HuynhMinhThuan1310/UAV-FLIGHT-CONTROLLER/mach-UAV-main/README.md

# UAV Project

Repository for developing a UAV (Unmanned Aerial Vehicle) system.

## Structure
- **hardware/** – UAV hardware design (schematic, PCB)
- **firmware/** – Microcontroller firmware
- **software/** – Supporting software and data processing

## Tools
- KiCad
- STM32CubeIDE
- Python / C++
