HuynhMinhThuan1310/UAV-FLIGHT-CONTROLLER/mach-UAV-main/firmware/README.md

# Firmware

This folder contains firmware for the UAV flight controller.

## Contents
- Microcontroller code
- Sensor drivers
- Motor control (PWM)

## Platform
STM32
