HuynhMinhThuan1310/UAV-FLIGHT-CONTROLLER/mach_flightcontroller (1) (1)/work/prior_layout_adapt/pcb-preview.png

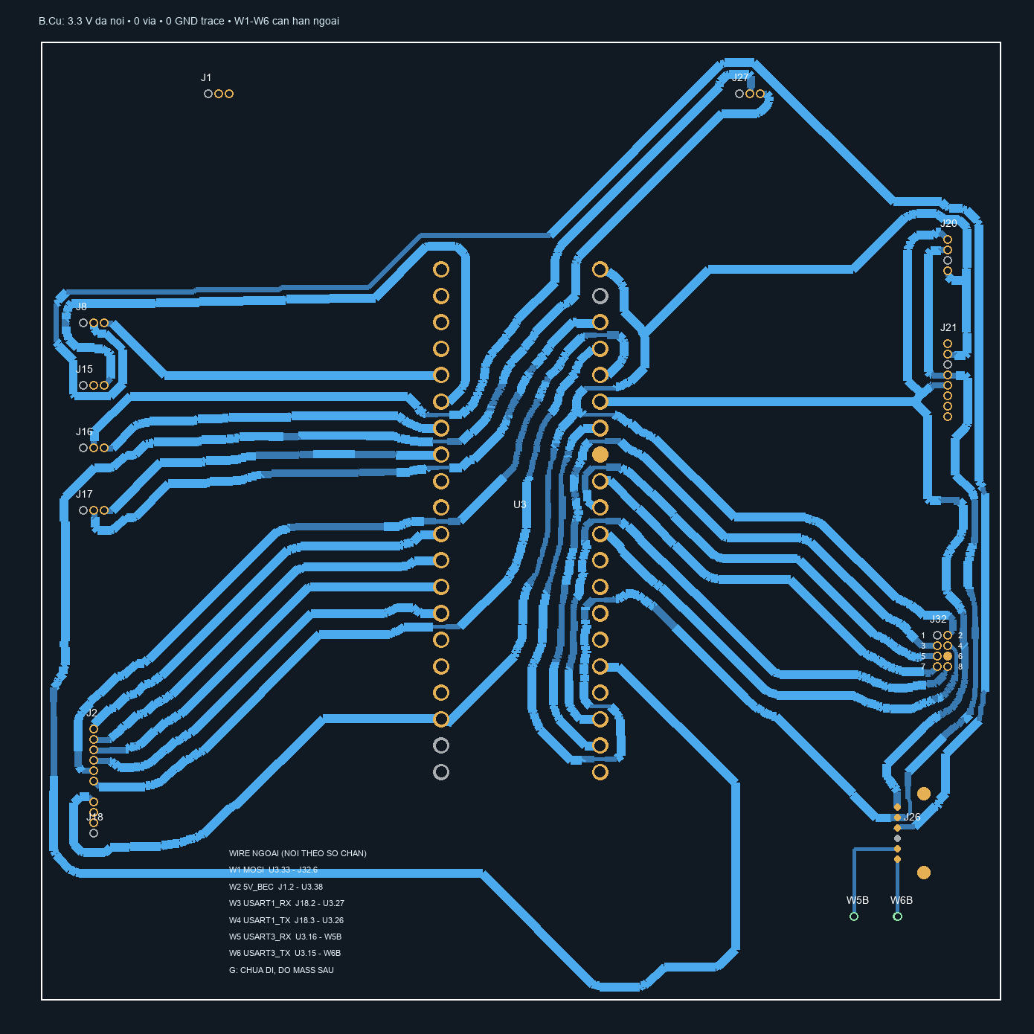
mach_flightcontroller (1) (1)/work/prior_layout_adapt/pcb-preview.png
