HuynhMinhThuan1310/UAV-FLIGHT-CONTROLLER/thiet_ke_mach/work/flightcontroller/pcb-preview.png

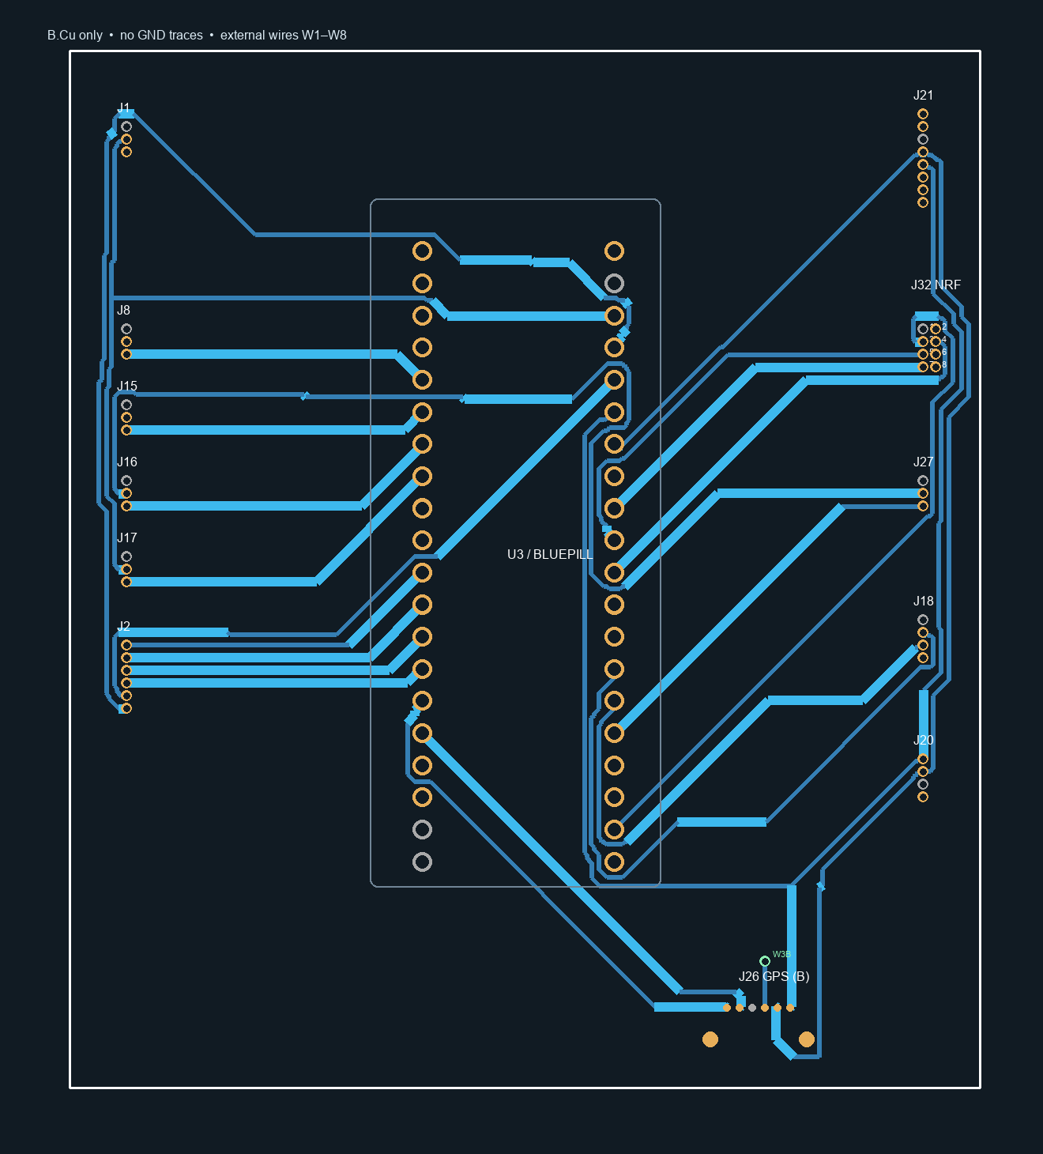
thiet_ke_mach/work/flightcontroller/pcb-preview.png
