HuynhMinhThuan1310/UAV-FLIGHT-CONTROLLER/thiet_ke_mach/work/flightcontroller/preview.png

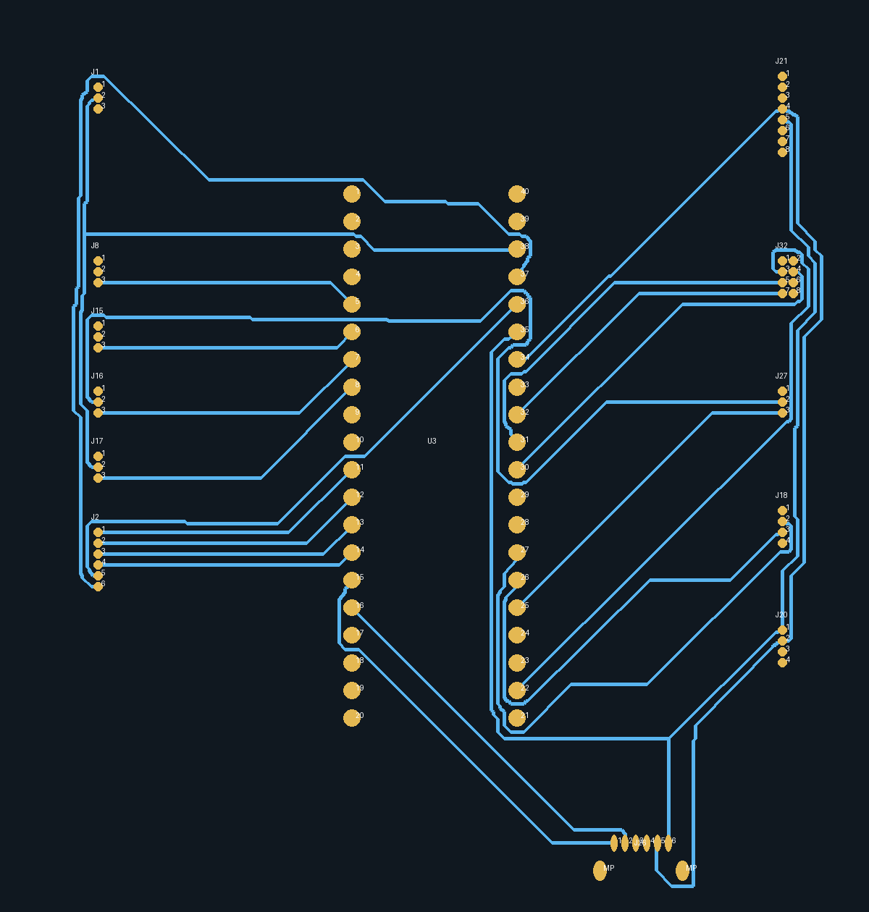
thiet_ke_mach/work/flightcontroller/preview.png
