HuynhMinhThuan1310/UAV-FLIGHT-CONTROLLER/thiet_ke_mach/work/no_ground_refined/preview.png

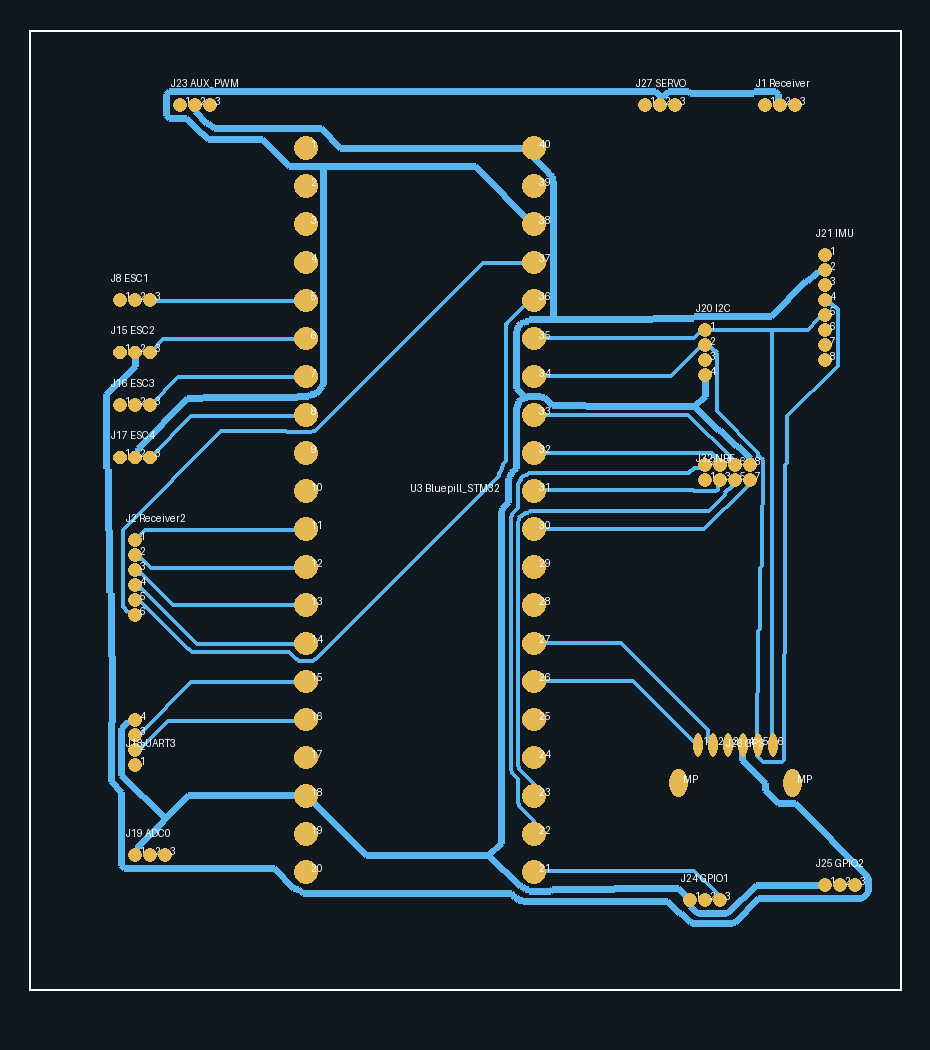
thiet_ke_mach/work/no_ground_refined/preview.png
