HuynhMinhThuan1310/UAV-FLIGHT-CONTROLLER/thiet_ke_mach/work/single_layer/preview.png

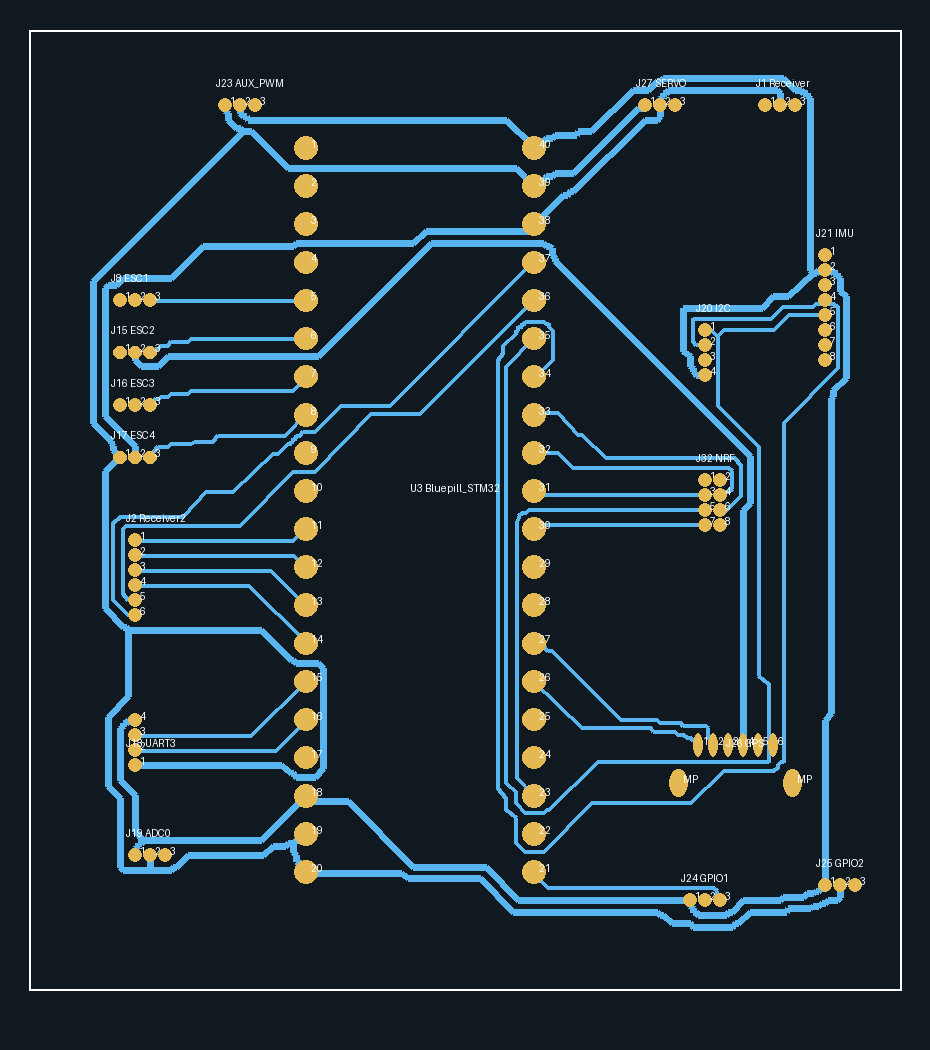
thiet_ke_mach/work/single_layer/preview.png
