HuynhMinhThuan1310/UAV-FLIGHT-CONTROLLER/thiet_ke_mach/work/no_ground_0/candidate.kicad_pcb

## KiCad design thiet_ke_mach/work/no_ground_0/candidate.kicad_pcb (2026-10-14)

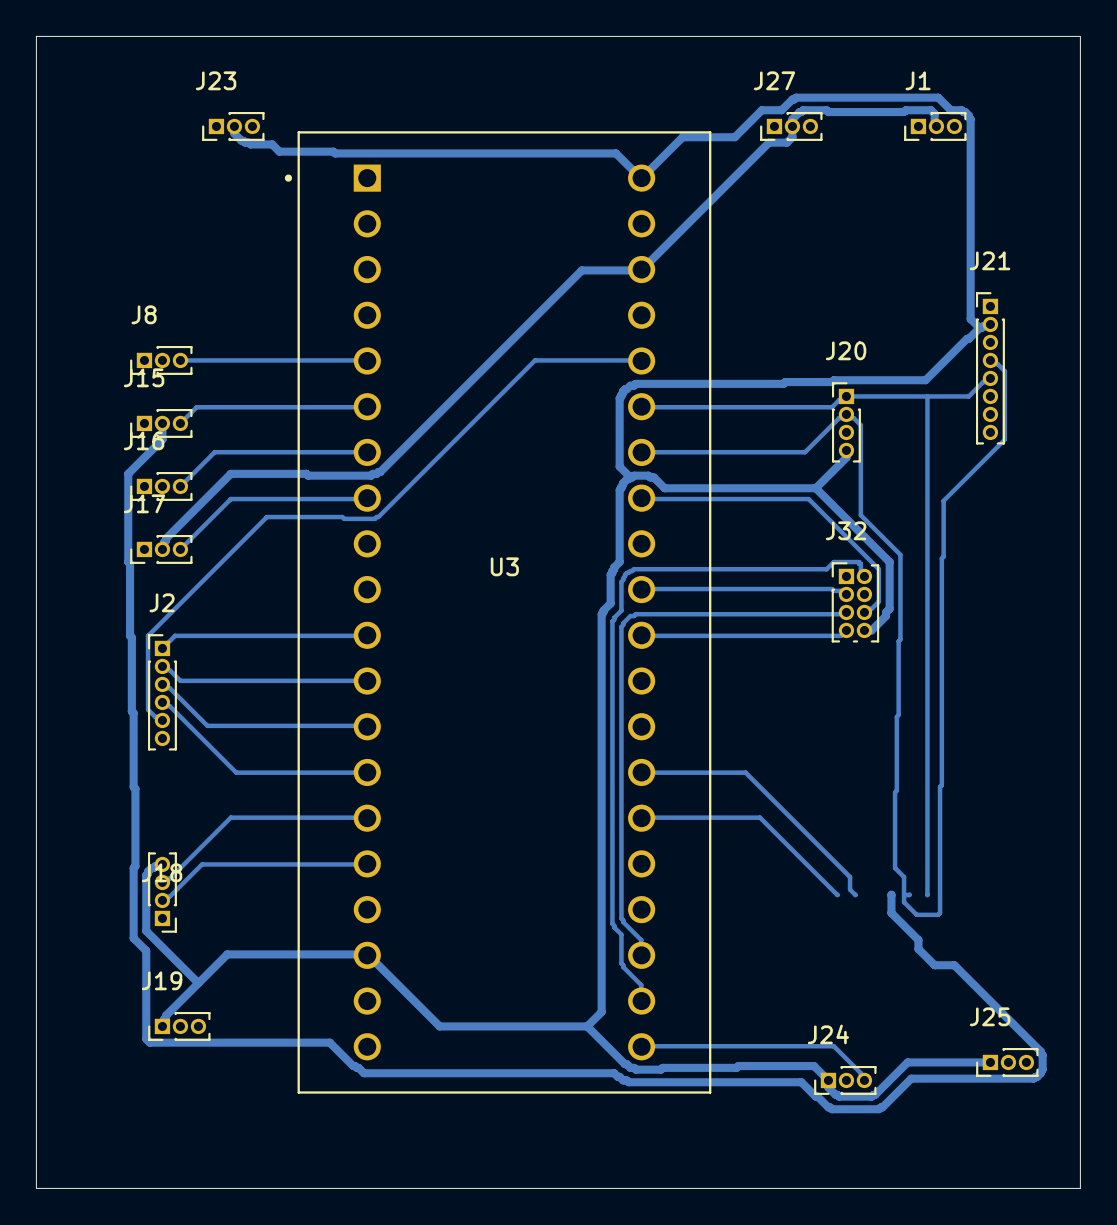
[picture p9: board candidate.kicad_pcb from above]

Board: 2 copper layers, 58.0 x 64.0 mm, 17 parts (1 on the bottom side), 27 nets.

Parts:
J1: Receiver; PinHeader_1x03_P1.00mm_Vertical
J2: Receiver2; PinHeader_1x06_P1.00mm_Vertical
J8: ESC1; PinHeader_1x03_P1.00mm_Vertical
J15: ESC2; PinHeader_1x03_P1.00mm_Vertical
J16: ESC3; PinHeader_1x03_P1.00mm_Vertical
J17: ESC4; PinHeader_1x03_P1.00mm_Vertical
J18: UART3; PinHeader_1x04_P1.00mm_Vertical
J19: ADC0; PinHeader_1x03_P1.00mm_Vertical
J20: I2C; PinHeader_1x04_P1.00mm_Vertical
J21: IMU; PinHeader_1x08_P1.00mm_Vertical
J23: AUX_PWM; PinHeader_1x03_P1.00mm_Vertical
J24: GPIO1; PinHeader_1x03_P1.00mm_Vertical
J25: GPIO2; PinHeader_1x03_P1.00mm_Vertical
J26: GPS; JST_SH_BM06B-SRSS-TB_1x06-1MP_P1.00mm_Vertical
J27: SERVO; PinHeader_1x03_P1.00mm_Vertical
J32: NRF; PinHeader_2x04_P1.00mm_Vertical
U3: Bluepill_STM32; MODULE_ZC323000

Connections:
3.3: J18.4, J19.1, J20.4, J21.2, J23.2, J24.1, J25.1, J32.8, U3.18 (3.3), U3.40 (3.3)
/5V_BEC: J1.2, J17.2, J27.2, U3.38 (5V)
/5V_BEC1: J15.2, J26.4
/B13: J32.2, U3.22 (B13)
/B14: J32.5, U3.23 (B14)
/ESC1: J8.3, U3.5 (A0)
/ESC2: J15.3, U3.6 (A1)
/ESC3: J16.3, U3.7 (A2)
/ESC4: J17.3, U3.8 (A3)
/GPIO1: J24.3, U3.21 (B12)
/RECV-CH6: J2.6, U3.37 (B9)
/RECV_CH1: J2.1, U3.11 (A6)
/RECV_CH2: J2.2, U3.12 (A7)
/RECV_CH3: J2.3, U3.13 (B0)
/RECV_CH4: J2.4, U3.14 (B1)
/RECV_CH5: J2.5, U3.36 (B8)
/SCL: J20.2, J21.4, J26.5, U3.34 (B6)
/SDA: J20.1, J21.5, J26.6, U3.35 (B7)
/SPI1_CS: J32.7, U3.30 (A15)
/SPI1_MISO: J32.4, U3.32 (B4)
/SPI1_MOSI: J32.6, U3.33 (B5)
/SPI1_SCK: J32.3, U3.31 (B3)
/USART1_RX: J26.2, U3.27 (A10)
/USART1_TX: J26.1, U3.26 (A9)
/USART3_RX: J18.2, U3.16 (B11)
/USART3_TX: J18.3, U3.15 (B10)
G: J1.1, J8.1, J15.1, J16.1, J17.1, J18.1, J19.2, J20.3, J21.3, J23.1, J24.2, J25.2, J26.3, J27.1, J32.1, U3.19 (G), U3.20 (G), U3.39 (G)
