HuynhMinhThuan1310/UAV-FLIGHT-CONTROLLER/mach-UAV-main/firmware/uav_complete_fc/Core/Src/main.c

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

/* Includes ------------------------------------------------------------------*/
#include "main.h"

/* USER CODE BEGIN Includes */
#include <math.h>
#include <stdbool.h>
#include <stdio.h>
#include <string.h>
#define USE_BARO                    0U
/* USER CODE END Includes */

/* USER CODE BEGIN PTD */
typedef struct {
  float ax;
  float ay;
  float az;
  float gx;
  float gy;
  float gz;
} ImuSample;

typedef struct {
  float roll_deg;
  float pitch_deg;
  float yaw_deg;
} AttitudeState;

typedef enum {
  FAILSAFE_NONE = 0,
  FAILSAFE_HOLD,
  FAILSAFE_DESCEND,
  FAILSAFE_RECOVER
} FailsafeMode;

typedef struct {
  float kp;
  float ki;
  float kd;
  float integrator;
  float prev_measurement;
  float d_filter;
  float integrator_limit;
  float output_limit;
} PidAxis;

typedef struct {
  bool valid;
  bool rf_loss_detected;
  bool throttle_low;
  bool yaw_arm_request;
  bool yaw_disarm_request;
  float throttle_norm;
  float roll_cmd;
  float pitch_cmd;
  float yaw_cmd;
  uint16_t raw[4];
} RcCommand;

#if USE_BARO
typedef struct {
  int16_t ac1;
  int16_t ac2;
  int16_t ac3;
  uint16_t ac4;
  uint16_t ac5;
  uint16_t ac6;
  int16_t b1;
  int16_t b2;
  int16_t mb;
  int16_t mc;
  int16_t md;
} Bmp180Calib;

typedef enum {
  BARO_STATE_IDLE = 0,
  BARO_STATE_WAIT_TEMP,
  BARO_STATE_WAIT_PRESS
} BaroState;
#endif

/* USER CODE END PTD */

/* USER CODE BEGIN PD */
#define RAD_TO_DEG                  57.29577951f
#define DEG_TO_RAD                  0.01745329252f

#define RC_CHANNELS                 4U

#define LOOP_HZ                     250U
#define LOG_PERIOD_DISARMED_MS      200U
#define LOG_PERIOD_ARMED_MS         500U

#define UART_TX_BUFFER_SIZE         1024U

#define RX_TIMEOUT_MS               120U
#define ARM_HOLD_MS                 3000U
#define DISARM_HOLD_MS              3000U

#define FAILSAFE_AIRBORNE_THROTTLE  0.18f
#define FAILSAFE_HOLD_MS            1300U
#define FAILSAFE_RECOVER_VALID_MS   400U
#define FAILSAFE_RECOVER_BLEND_MS   900U
#define FAILSAFE_DESCEND_RATE_HIGH  0.07f
#define FAILSAFE_DESCEND_RATE_LOW   0.035f
#define FAILSAFE_DESCEND_SPLIT      0.18f
#define FAILSAFE_DESCEND_MIN        0.12f
#define FAILSAFE_DESCEND_FINAL      0.07f
#define FAILSAFE_LAND_ATTITUDE_DEG  14.0f
#define FAILSAFE_LAND_RATE_DPS      35.0f
#define FAILSAFE_LAND_STABLE_MS     1200U
#define RF_PRESET_CENTER_US         1500U
#define RF_PRESET_WINDOW_US         12U
#define RF_PRESET_THROTTLE_MAX_US   950U
#define RF_PRESET_DETECT_MS         120U

#define MOTOR_STOP_US               1000U
#define MOTOR_IDLE_US               1060U
#define MOTOR_MAX_US                2000U
#define MOTOR_HEADROOM_US           260U
#define THROTTLE_LOW_US             1165U

#define RC_VALID_MIN_US             850U
#define RC_VALID_MAX_US             2200U
#define RC_DEADBAND_US              24U

/* Updated from the latest bench logs on the current airframe/radio. */
#define RC_ROLL_MIN_US              1310U
#define RC_ROLL_CENTER_US           1539U
#define RC_ROLL_MAX_US              1808U

#define RC_PITCH_MIN_US             1290U
#define RC_PITCH_CENTER_US          1525U
#define RC_PITCH_MAX_US             1789U

#define RC_YAW_MIN_US               1259U
#define RC_YAW_CENTER_US            1508U
#define RC_YAW_MAX_US               1760U

#define RC_THROTTLE_MIN_US          990U
#define RC_THROTTLE_MAX_US          2120U

#define ARM_YAW_HIGH_US             1700U
#define DISARM_YAW_LOW_US           1320U
#define ARM_STICK_CENTER_WINDOW_US  120U

#define MAX_ANGLE_DEG               14.0f
#define MAX_ANGLE_RATE_DPS          140.0f
#define MAX_YAW_RATE_DPS            140.0f
#define ANGLE_OUTER_KP              5.0f
#define CENTER_BRAKE_STICK_THRESH   0.15f
#define CENTER_BRAKE_KP_BOOST       1.0f
#define HEADING_HOLD_YAW_DEADBAND   0.05f
#define HEADING_HOLD_YAW_EXIT_DB     0.09f
#define HEADING_HOLD_KP             1.85f
#define HEADING_HOLD_RATE_LIMIT_DPS 55.0f
#define HEADING_HOLD_ERROR_LIMIT_DEG 24.0f
#define HEADING_HOLD_RELEASE_MS     120U
#define HEADING_HOLD_MIN_THROTTLE   0.10f
#define HEADING_HOLD_MAX_RP_STICK   0.18f
#define HEADING_HOLD_MAX_TILT_DEG   8.0f
#define HEADING_HOLD_MAX_RP_RATE_DPS 65.0f
#define ACCEL_CORRECTION_GAIN       2.4f
#define ACCEL_TRUST_MAX_ERROR_G     0.35f
#define MAG_YAW_CORRECTION_GAIN     0.30f
#define MAG_CORRECTION_MAX_TILT_DEG 18.0f
#define MAG_CORRECTION_MAX_RP_RATE_DPS 90.0f
#define MAG_CORRECTION_MIN_ACCEL_TRUST 0.35f
#define MAG_CORRECTION_MAX_THR_DELTA 0.040f
#define MAG_FIELD_MIN_GAUSS         0.08f
#define MAG_FIELD_MAX_GAUSS         2.50f
#define MAG_HEADING_JUMP_DEG        35.0f
#define MAG_HEALTH_RECOVER_MS       300U
#define MAG_RAW_LPF_ALPHA           0.12f
#define RC_CENTER_LEARN_ALPHA       0.010f
#define RC_CENTER_LEARN_WINDOW_US   70U
#define RC_CENTER_LEARN_MIN_MS      1200U
#define TILT_THROTTLE_MIN           0.18f
#define TILT_THROTTLE_MAX_BOOST     0.16f
#define YAW_MANEUEVER_STICK_THRESH  0.18f
#define YAW_CONTROL_MIN_THROTTLE    0.10f
#define YAW_MANEUVER_AUTHORITY_MIN  0.60f
#define YAW_INTEGRATOR_DECAY_MANEUVER 0.92f
#define YAW_AUTHORITY_FLOOR         0.68f
#define YAW_DYNAMIC_DAMPING_KP      0.70f
#define YAW_DYNAMIC_DAMPING_THR_KP  0.95f
#define YAW_DYNAMIC_DAMPING_RP_KP   0.55f
#define YAW_THROTTLE_FF            -28.0f
#define YAW_THROTTLE_HIGH_FF       -52.0f
#define YAW_THROTTLE_DELTA_FF      -3.2f
#define YAW_TAKEOFF_BIAS_FF        -9.0f
#define YAW_ROLL_COUPLING_FF        0.0f
#define YAW_PITCH_COUPLING_FF       0.0f
#define YAW_RP_MANEUVER_BIAS_FF    -32.0f
#define YAW_RP_OUTPUT_BIAS_FF      -0.105f
#define YAW_RP_RATE_BIAS_FF        -0.055f
#define YAW_RP_BIAS_THR_GAIN        1.65f
#define YAW_RP_BIAS_LIMIT           115.0f
#define YAW_MIX_SIGN                1.0f
#define YAW_SAT_INTEGRATOR_DECAY    0.94f
#define YAW_BIAS_LEARN_MIN_THROTTLE 0.18f
#define YAW_BIAS_LEARN_MAX_RATE_DPS 85.0f
#define YAW_BIAS_LEARN_GAIN         4.0f
#define YAW_BIAS_DECAY              0.995f
#define YAW_BIAS_SAT_DECAY          0.980f
#define YAW_BIAS_LIMIT              130.0f
#define SENSOR_LEVEL_ROLL_OFFSET_DEG  0.0f
#define SENSOR_LEVEL_PITCH_OFFSET_DEG 0.0f
#define HOVER_ROLL_TRIM_DEG           0.5f
#define HOVER_PITCH_TRIM_DEG          1.6f
#define HOVER_TRIM_START_THROTTLE     0.12f
#define HOVER_TRIM_FULL_THROTTLE      0.35f
#define TAKEOFF_ASSIST_MIN_THROTTLE   0.16f
#define TAKEOFF_ASSIST_MAX_THROTTLE   0.42f
#define TAKEOFF_ASSIST_STICK_THRESH   0.12f
#define TAKEOFF_ASSIST_KP_BOOST       1.0f
#define TAKEOFF_ROLL_TRIM_DEG         0.3f
#define TAKEOFF_PITCH_TRIM_DEG        0.8f
#define STICK_EXPO                  0.70f

#define GYRO_LPF_HZ                 42.0f
#define ACCEL_LPF_HZ                10.0f
#define RC_STICK_ALPHA              0.42f
#define RC_YAW_ALPHA                0.50f
#define RC_THROTTLE_ALPHA           0.06f
#define THROTTLE_EXPO               0.42f
#define THROTTLE_SLEW_UP_PER_S      3.00f
#define THROTTLE_SLEW_DOWN_PER_S    1.50f
#define COMPLEMENTARY_ALPHA         0.985f
#define PID_D_FILTER_CUTOFF_HZ      32.0f

#define GYRO_CALIB_SAMPLES          800U
#define ACCEL_CALIB_SAMPLES         400U
#define IMU_FAIL_LIMIT              10U

#define SENSOR_ROTATION_0           0U
#define SENSOR_ROTATION_90          1U
#define SENSOR_ROTATION_180         2U
#define SENSOR_ROTATION_270         3U
#define SENSOR_ROTATION             SENSOR_ROTATION_0
#define MAG_ROTATION                SENSOR_ROTATION

#define RC_ROLL_SIGN                1.0f
#define RC_PITCH_SIGN              -1.0f
#define RC_YAW_SIGN                 1.0f
#define GYRO_Z_SIGN                 -1.0f
#define MAG_X_SIGN                  1.0f
#define MAG_Y_SIGN                  1.0f
#define MAG_Z_SIGN                  1.0f
#define MAG_OFFSET_X               -0.72f
#define MAG_OFFSET_Y                0.02f
#define MAG_OFFSET_Z                0.00f

#define MPU6050_ADDR                (0x68U << 1)
#define HMC5883L_ADDR               (0x1EU << 1)
#define MPU_REG_SMPLRT_DIV          0x19U
#define MPU_REG_CONFIG              0x1AU
#define MPU_REG_GYRO_CONFIG         0x1BU
#define MPU_REG_ACCEL_CONFIG        0x1CU
#define MPU_REG_INT_PIN_CFG         0x37U
#define MPU_REG_ACCEL_XOUT_H        0x3BU
#define MPU_REG_PWR_MGMT_1          0x6BU
#define MPU_REG_WHO_AM_I            0x75U

#define HMC_REG_CONFIG_A            0x00U
#define HMC_REG_CONFIG_B            0x01U
#define HMC_REG_MODE                0x02U
#define HMC_REG_DATA_X_MSB          0x03U

#define MAG_UPDATE_MS               20U
#define MAG_FAIL_LIMIT              10U

#define MPU_ACCEL_SCALE_4G          8192.0f
#define MPU_GYRO_SCALE_500DPS       65.5f

#define SOFT_I2C_SCL_Pin            GPIO_PIN_6
#define SOFT_I2C_SCL_GPIO_Port      GPIOB
#define SOFT_I2C_SDA_Pin            GPIO_PIN_7
#define SOFT_I2C_SDA_GPIO_Port      GPIOB

#define I2C_TIMEOUT_US              3000U
#define I2C_TIMEOUT_LONG_US         12000U
/* USER CODE END PD */

TIM_HandleTypeDef htim2;
TIM_HandleTypeDef htim3;
UART_HandleTypeDef huart1;

/* USER CODE BEGIN PV */
static volatile uint32_t rc_rise_ticks[RC_CHANNELS] = {0U, 0U, 0U, 0U};
static volatile uint16_t rc_pulse_us[RC_CHANNELS] = {1500U, 1500U, 1000U, 1500U};
static volatile uint8_t rc_edge_state[RC_CHANNELS] = {0U, 0U, 0U, 0U};
static volatile uint32_t rc_last_update_ms[RC_CHANNELS] = {0U, 0U, 0U, 0U};

static uint16_t motor_output_us[4] = {
  MOTOR_STOP_US, MOTOR_STOP_US, MOTOR_STOP_US, MOTOR_STOP_US
};

static AttitudeState attitude = {0.0f, 0.0f, 0.0f};

static PidAxis pid_roll  = {1.18f, 0.42f, 0.046f, 0.0f, 0.0f, 0.0f, 95.0f, 300.0f};
static PidAxis pid_pitch = {1.18f, 0.42f, 0.046f, 0.0f, 0.0f, 0.0f, 95.0f, 300.0f};
static PidAxis pid_yaw   = {2.60f, 0.55f, 0.000f, 0.0f, 0.0f, 0.0f, 120.0f, 340.0f};

static float gyro_bias_x_dps = 0.0f;
static float gyro_bias_y_dps = 0.0f;
static float gyro_bias_z_dps = 0.0f;
static float accel_roll_trim = 0.0f;
static float accel_pitch_trim = 0.0f;

static float gyro_lpf_x = 0.0f;
static float gyro_lpf_y = 0.0f;
static float gyro_lpf_z = 0.0f;
static float accel_lpf_x = 0.0f;
static float accel_lpf_y = 0.0f;
static float accel_lpf_z = 1.0f;

static float rc_roll_filtered = 0.0f;
static float rc_pitch_filtered = 0.0f;
static float rc_yaw_filtered = 0.0f;
static float rc_throttle_filtered = 0.0f;

static bool imu_ready = false;
static bool armed = false;
static bool failsafe_active = true;
static FailsafeMode failsafe_mode = FAILSAFE_NONE;
static uint8_t imu_fail_streak = 0U;
static uint32_t arm_request_ms = 0U;
static uint32_t disarm_request_ms = 0U;
static uint32_t failsafe_state_ms = 0U;
static uint32_t rf_recover_ms = 0U;
static uint32_t land_detect_ms = 0U;
static float failsafe_throttle_norm = 0.0f;
static float last_pilot_throttle_norm = 0.0f;
#if USE_BARO
static Bmp180Calib bmp180_calib = {0};
static BaroState baro_state = BARO_STATE_IDLE;
#endif
static bool mag_ready = false;
static bool mag_usable = false;
static bool mag_correction_allowed = false;
static bool heading_hold_engaged = false;
static bool heading_hold_allowed = false;
static bool mag_calibrated = true;
static uint8_t mag_fail_streak = 0U;
#if USE_BARO
static uint8_t baro_fail_streak = 0U;
#endif
static uint32_t last_mag_update_ms = 0U;
#if USE_BARO
static uint32_t last_baro_update_ms = 0U;
#endif
static uint32_t last_heading_hold_ms = 0U;
static uint32_t rf_preset_detect_ms = 0U;
static uint32_t mag_good_since_ms = 0U;
static uint32_t rc_center_learn_ms = 0U;
#if USE_BARO
static uint32_t baro_deadline_ms = 0U;
#endif
static float throttle_command_norm = 0.0f;
static float heading_deg = 0.0f;
static float heading_hold_ref_deg = 0.0f;
static float mag_heading_deg = 0.0f;
static float mag_field_strength = 0.0f;
static float mag_field_filtered = 0.0f;
static float mag_heading_jump = 0.0f;
static float mag_offset_x = MAG_OFFSET_X;
static float mag_offset_y = MAG_OFFSET_Y;
static float mag_offset_z = MAG_OFFSET_Z;
static float mag_raw_x = 0.0f;
static float mag_raw_y = 0.0f;
static float mag_raw_z = 0.0f;
static float mag_lpf_x = 0.0f;
static float mag_lpf_y = 0.0f;
static float mag_lpf_z = 0.0f;
static bool mag_heading_valid = false;
static float rc_roll_center_runtime = (float)RC_ROLL_CENTER_US;
static float rc_pitch_center_runtime = (float)RC_PITCH_CENTER_US;
static float rc_yaw_center_runtime = (float)RC_YAW_CENTER_US;
static float accel_norm = 1.0f;
static float accel_trust = 0.0f;
static float throttle_tilt_boost = 0.0f;
static float takeoff_assist_scale = 0.0f;
static float last_roll_pid_output = 0.0f;
static float last_pitch_pid_output = 0.0f;
static float last_yaw_pid_output = 0.0f;
static float last_desired_yaw_rate = 0.0f;
static float last_gyro_x_dps = 0.0f;
static float last_gyro_y_dps = 0.0f;
static float last_heading_error_deg = 0.0f;
static float last_gyro_z_dps = 0.0f;
static float last_control_throttle_norm = 0.0f;
static float throttle_delta_norm = 0.0f;
static float throttle_rate_norm_s = 0.0f;
static float yaw_dynamic_damping_output = 0.0f;
static float yaw_throttle_feedforward_output = 0.0f;
static float yaw_feedforward_output = 0.0f;
static float yaw_maneuver_bias_output = 0.0f;
static float yaw_bias_output = 0.0f;
static float heading_hold_limited_error_deg = 0.0f;
static float mixer_yaw_scale = 1.0f;
static float mixer_rp_scale = 1.0f;
static float yaw_maneuver_scale = 1.0f;
static bool roll_pitch_dynamic = false;
static bool mixer_saturated = false;
#if USE_BARO
static float baro_temperature_c = 0.0f;
static float baro_pressure_hpa = 0.0f;
static float baro_pressure_filtered_hpa = 0.0f;
static float baro_altitude_m = 0.0f;
static float baro_altitude_filtered_m = 0.0f;
static float baro_altitude_ref_m = 0.0f;
static float baro_relative_altitude_m = 0.0f;
static int32_t baro_ut = 0;
static int32_t baro_b5 = 0;
static bool baro_ref_valid = false;
static float baro_ref_accum_m = 0.0f;
static uint16_t baro_ref_samples = 0U;
#endif

static char uart_buf[768];
static volatile char uart_tx_ring[UART_TX_BUFFER_SIZE];
static volatile uint16_t uart_tx_head = 0U;
static volatile uint16_t uart_tx_tail = 0U;
/* USER CODE END PV */

void SystemClock_Config(void);
static void MX_GPIO_Init(void);
static void MX_TIM2_Init(void);
static void MX_TIM3_Init(void);
static void MX_USART1_UART_Init(void);
/* USER CODE BEGIN PFP */
static void dwt_init(void);
static uint32_t dwt_cycles32(void);
static void uart_log(const char *text);
static void uart_start_tx(void);
static void set_status_led(bool on);
static void update_status_led(void);

static float clampf(float value, float min_value, float max_value);
static float apply_expo(float value, float expo);
static float lpf_alpha(float cutoff_hz, float dt);
static float lpf_apply(float previous, float input, float alpha);
static uint16_t pulse_distance_us(uint16_t a, uint16_t b);
static float normalize_centered(uint16_t pulse_us,
                                uint16_t min_us,
                                float center_us,
                                uint16_t max_us,
                                float sign);
static float normalize_throttle(uint16_t pulse_us);
static float apply_throttle_curve(float value);
static void rotate_xy(float *x, float *y);
static void rotate_mag_axes(float *x, float *y, float *z);
static void update_rc_center_learning(RcCommand *command, uint32_t now_ms);
static float control_roll_accel_deg(const ImuSample *sample);
static float control_pitch_accel_deg(const ImuSample *sample);
static float control_roll_rate_dps(const ImuSample *sample);
static float control_pitch_rate_dps(const ImuSample *sample);
static float control_yaw_rate_dps(const ImuSample *sample);
static float hover_trim_scale(float throttle_norm);

static void pid_reset(PidAxis *pid);
static void reset_all_pids(void);
static float pid_update(PidAxis *pid, float setpoint, float measurement, float dt, bool enable_integrator);

static void hw_i2c1_init(void);
static bool hw_i2c_wait_flag(volatile uint32_t *reg, uint32_t flag, bool set, uint32_t timeout_us);
static bool hw_i2c_write_register(uint8_t device_addr, uint8_t reg, uint8_t value);
static bool hw_i2c_read_registers(uint8_t device_addr, uint8_t reg, uint8_t *buffer, uint16_t length);
static bool imu_write_reg(uint8_t reg, uint8_t value);
static bool imu_read_regs(uint8_t reg, uint8_t *buffer, uint16_t length);
static bool mpu6050_init(void);
static bool mpu6050_enable_bypass(void);
static bool mpu6050_read_raw(ImuSample *sample);
static bool mpu6050_read_filtered(ImuSample *sample, float dt);
static bool mpu6050_calibrate(void);
static void update_attitude(const ImuSample *sample, float dt);

static bool receiver_read_command(RcCommand *command, uint32_t now_ms);
static bool hmc5883l_init(void);
static bool hmc5883l_read(float *mx, float *my, float *mz);
static float wrap_heading_deg(float heading_deg_value);
static float heading_error_deg(float target_deg, float current_deg);
static float compute_heading_deg(float mx, float my, float mz, float pitch_deg, float roll_deg);
#if USE_BARO
static bool bmp180_read_calib(void);
static float compute_altitude_m(float pressure_hpa);
static bool bmp180_start_temp(void);
static bool bmp180_read_ut(int32_t *ut);
static bool bmp180_start_pressure(void);
static bool bmp180_read_up(int32_t *up);
static void bmp180_compute(int32_t ut, int32_t up, float *temperature_c, float *pressure_hpa);
#endif
static void update_aux_sensors(uint32_t now_ms);

static bool detect_rf_loss_pattern(const RcCommand *command);
static bool command_is_centered(const RcCommand *command);
static void update_failsafe_state(const RcCommand *command,
                                  bool sensors_ok,
                                  const ImuSample *sample,
                                  bool sample_valid,
                                  uint32_t now_ms,
                                  float dt);
static void update_arming_state(const RcCommand *command, bool sensors_ok, uint32_t now_ms);
static float apply_throttle_slew(float target_norm, float dt, bool reset_state);
static void build_control_command(const RcCommand *pilot_command,
                                  RcCommand *control_command,
                                  uint32_t now_ms,
                                  float dt);
static void enter_rf_failsafe(uint32_t now_ms);

static void motor_set_us(uint8_t motor_index, uint16_t pulse_us);
static void motors_write_all(uint16_t m1, uint16_t m2, uint16_t m3, uint16_t m4);
static void stop_all_motors(void);
static void mix_motor_outputs(float throttle_base,
                              float roll_output,
                              float pitch_output,
                              float yaw_output);
static void run_flight_control(const RcCommand *command, const ImuSample *sample, float dt);
static void log_status(const RcCommand *command);
/* USER CODE END PFP */

/* USER CODE BEGIN 0 */
static void dwt_init(void)
{
  CoreDebug->DEMCR |= CoreDebug_DEMCR_TRCENA_Msk;
  DWT->CYCCNT = 0U;
  DWT->CTRL |= DWT_CTRL_CYCCNTENA_Msk;
}

static uint32_t dwt_cycles32(void)
{
  return DWT->CYCCNT;
}

static void uart_log(const char *text)
{
  __disable_irq();

  while (*text != '\0') {
    const uint16_t next_head = (uint16_t)((uart_tx_head + 1U) % UART_TX_BUFFER_SIZE);

    if (next_head == uart_tx_tail) {
      break;
    }

    uart_tx_ring[uart_tx_head] = *text;
    uart_tx_head = next_head;
    text++;
  }

  __enable_irq();
  uart_start_tx();
}

static void uart_start_tx(void)
{
  __HAL_UART_ENABLE_IT(&huart1, UART_IT_TXE);
}

void uart1_irq_handler(void)
{
  if ((__HAL_UART_GET_IT_SOURCE(&huart1, UART_IT_TXE) != RESET) &&
      (__HAL_UART_GET_FLAG(&huart1, UART_FLAG_TXE) != RESET)) {
    if (uart_tx_tail != uart_tx_head) {
      huart1.Instance->DR = (uint16_t)(uint8_t)uart_tx_ring[uart_tx_tail];
      uart_tx_tail = (uint16_t)((uart_tx_tail + 1U) % UART_TX_BUFFER_SIZE);
    } else {
      __HAL_UART_DISABLE_IT(&huart1, UART_IT_TXE);
    }
  }
}

static void set_status_led(bool on)
{
  HAL_GPIO_WritePin(STATUS_LED_GPIO_Port,
                    STATUS_LED_Pin,
                    on ? GPIO_PIN_RESET : GPIO_PIN_SET);
}

static void update_status_led(void)
{
  static uint32_t last_toggle_ms = 0U;
  static bool led_on = false;
  const uint32_t now_ms = HAL_GetTick();
  uint32_t period_ms = 500U;

  if (!imu_ready) {
    period_ms = 120U;
  } else if (failsafe_active) {
    period_ms = 100U;
  } else if (!armed) {
    period_ms = 450U;
  } else {
    set_status_led(true);
    return;
  }

  if ((uint32_t)(now_ms - last_toggle_ms) >= period_ms) {
    last_toggle_ms = now_ms;
    led_on = !led_on;
    set_status_led(led_on);
  }
}

static void hw_i2c1_init(void)
{
  GPIO_InitTypeDef GPIO_InitStruct = {0};

  __HAL_RCC_GPIOB_CLK_ENABLE();
  __HAL_RCC_I2C1_CLK_ENABLE();

  GPIO_InitStruct.Pin = SOFT_I2C_SCL_Pin | SOFT_I2C_SDA_Pin;
  GPIO_InitStruct.Mode = GPIO_MODE_OUTPUT_OD;
  GPIO_InitStruct.Speed = GPIO_SPEED_FREQ_HIGH;
  HAL_GPIO_Init(GPIOB, &GPIO_InitStruct);

  HAL_GPIO_WritePin(GPIOB, SOFT_I2C_SCL_Pin | SOFT_I2C_SDA_Pin, GPIO_PIN_SET);
  for (uint8_t i = 0U; i < 9U; i++) {
    HAL_GPIO_WritePin(GPIOB, SOFT_I2C_SCL_Pin, GPIO_PIN_RESET);
    for (volatile uint32_t delay = 0U; delay < 80U; delay++) { __NOP(); }
    HAL_GPIO_WritePin(GPIOB, SOFT_I2C_SCL_Pin, GPIO_PIN_SET);
    for (volatile uint32_t delay = 0U; delay < 80U; delay++) { __NOP(); }
  }
  HAL_GPIO_WritePin(GPIOB, SOFT_I2C_SDA_Pin, GPIO_PIN_RESET);
  for (volatile uint32_t delay = 0U; delay < 80U; delay++) { __NOP(); }
  HAL_GPIO_WritePin(GPIOB, SOFT_I2C_SCL_Pin, GPIO_PIN_SET);
  for (volatile uint32_t delay = 0U; delay < 80U; delay++) { __NOP(); }
  HAL_GPIO_WritePin(GPIOB, SOFT_I2C_SDA_Pin, GPIO_PIN_SET);

  GPIO_InitStruct.Pin = SOFT_I2C_SCL_Pin | SOFT_I2C_SDA_Pin;
  GPIO_InitStruct.Mode = GPIO_MODE_AF_OD;
  GPIO_InitStruct.Speed = GPIO_SPEED_FREQ_HIGH;
  HAL_GPIO_Init(GPIOB, &GPIO_InitStruct);

  __HAL_RCC_I2C1_FORCE_RESET();
  __HAL_RCC_I2C1_RELEASE_RESET();

  I2C1->CR1 = 0U;
  I2C1->CR2 = 36U;
  I2C1->CCR = 180U;
  I2C1->TRISE = 37U;
  I2C1->CR1 = I2C_CR1_PE;
}

static bool hw_i2c_wait_flag(volatile uint32_t *reg, uint32_t flag, bool set, uint32_t timeout_us)
{
  const uint32_t start = dwt_cycles32();
  const uint32_t timeout_cycles = timeout_us * (SystemCoreClock / 1000000U);

  while (((*reg & flag) != 0U) != set) {
    if ((uint32_t)(dwt_cycles32() - start) > timeout_cycles) {
      return false;
    }
  }
  return true;
}

static bool hw_i2c_write_register(uint8_t device_addr, uint8_t reg, uint8_t value)
{
  if (!hw_i2c_wait_flag(&I2C1->SR2, I2C_SR2_BUSY, false, I2C_TIMEOUT_LONG_US)) {
    hw_i2c1_init();
    return false;
  }

  I2C1->CR1 |= I2C_CR1_START;
  if (!hw_i2c_wait_flag(&I2C1->SR1, I2C_SR1_SB, true, I2C_TIMEOUT_US)) {
    hw_i2c1_init();
    return false;
  }
  I2C1->DR = device_addr & 0xFEU;
  if (!hw_i2c_wait_flag(&I2C1->SR1, I2C_SR1_ADDR, true, I2C_TIMEOUT_US)) {
    I2C1->CR1 |= I2C_CR1_STOP;
    hw_i2c1_init();
    return false;
  }
  (void)I2C1->SR1;
  (void)I2C1->SR2;

  if (!hw_i2c_wait_flag(&I2C1->SR1, I2C_SR1_TXE, true, I2C_TIMEOUT_US)) {
    I2C1->CR1 |= I2C_CR1_STOP;
    return false;
  }
  I2C1->DR = reg;
  if (!hw_i2c_wait_flag(&I2C1->SR1, I2C_SR1_BTF, true, I2C_TIMEOUT_US)) {
    I2C1->CR1 |= I2C_CR1_STOP;
    return false;
  }
  I2C1->DR = value;
  if (!hw_i2c_wait_flag(&I2C1->SR1, I2C_SR1_BTF, true, I2C_TIMEOUT_US)) {
    I2C1->CR1 |= I2C_CR1_STOP;
    return false;
  }

  I2C1->CR1 |= I2C_CR1_STOP;
  return true;
}

static bool hw_i2c_read_registers(uint8_t device_addr, uint8_t reg, uint8_t *buffer, uint16_t length)
{
  if (length == 0U) {
    return true;
  }

  if (!hw_i2c_wait_flag(&I2C1->SR2, I2C_SR2_BUSY, false, I2C_TIMEOUT_LONG_US)) {
    hw_i2c1_init();
    return false;
  }

  I2C1->CR1 |= I2C_CR1_ACK;
  I2C1->CR1 |= I2C_CR1_START;
  if (!hw_i2c_wait_flag(&I2C1->SR1, I2C_SR1_SB, true, I2C_TIMEOUT_US)) {
    hw_i2c1_init();
    return false;
  }
  I2C1->DR = device_addr & 0xFEU;
  if (!hw_i2c_wait_flag(&I2C1->SR1, I2C_SR1_ADDR, true, I2C_TIMEOUT_US)) {
    I2C1->CR1 |= I2C_CR1_STOP;
    hw_i2c1_init();
    return false;
  }
  (void)I2C1->SR1;
  (void)I2C1->SR2;

  if (!hw_i2c_wait_flag(&I2C1->SR1, I2C_SR1_TXE, true, I2C_TIMEOUT_US)) {
    I2C1->CR1 |= I2C_CR1_STOP;
    return false;
  }
  I2C1->DR = reg;
  if (!hw_i2c_wait_flag(&I2C1->SR1, I2C_SR1_BTF, true, I2C_TIMEOUT_US)) {
    I2C1->CR1 |= I2C_CR1_STOP;
    return false;
  }

  I2C1->CR1 |= I2C_CR1_START;
  if (!hw_i2c_wait_flag(&I2C1->SR1, I2C_SR1_SB, true, I2C_TIMEOUT_US)) {
    hw_i2c1_init();
    return false;
  }
  I2C1->DR = device_addr | 0x01U;

  if (length == 1U) {
    if (!hw_i2c_wait_flag(&I2C1->SR1, I2C_SR1_ADDR, true, I2C_TIMEOUT_US)) {
      I2C1->CR1 |= I2C_CR1_STOP;
      return false;
    }
    I2C1->CR1 &= ~I2C_CR1_ACK;
    __disable_irq();
    (void)I2C1->SR1;
    (void)I2C1->SR2;
    I2C1->CR1 |= I2C_CR1_STOP;
    __enable_irq();
    if (!hw_i2c_wait_flag(&I2C1->SR1, I2C_SR1_RXNE, true, I2C_TIMEOUT_US)) {
      return false;
    }
    buffer[0] = (uint8_t)I2C1->DR;
    I2C1->CR1 |= I2C_CR1_ACK;
    return true;
  }

  if (length == 2U) {
    I2C1->CR1 |= I2C_CR1_POS;
    if (!hw_i2c_wait_flag(&I2C1->SR1, I2C_SR1_ADDR, true, I2C_TIMEOUT_US)) {
      I2C1->CR1 |= I2C_CR1_STOP;
      I2C1->CR1 &= ~I2C_CR1_POS;
      return false;
    }
    I2C1->CR1 &= ~I2C_CR1_ACK;
    __disable_irq();
    (void)I2C1->SR1;
    (void)I2C1->SR2;
    __enable_irq();
    if (!hw_i2c_wait_flag(&I2C1->SR1, I2C_SR1_BTF, true, I2C_TIMEOUT_US)) {
      I2C1->CR1 &= ~I2C_CR1_POS;
      return false;
    }
    __disable_irq();
    I2C1->CR1 |= I2C_CR1_STOP;
    buffer[0] = (uint8_t)I2C1->DR;
    __enable_irq();
    buffer[1] = (uint8_t)I2C1->DR;
    I2C1->CR1 &= ~I2C_CR1_POS;
    I2C1->CR1 |= I2C_CR1_ACK;
    return true;
  }

  if (!hw_i2c_wait_flag(&I2C1->SR1, I2C_SR1_ADDR, true, I2C_TIMEOUT_US)) {
    I2C1->CR1 |= I2C_CR1_STOP;
    return false;
  }
  (void)I2C1->SR1;
  (void)I2C1->SR2;

  while (length > 3U) {
    if (!hw_i2c_wait_flag(&I2C1->SR1, I2C_SR1_RXNE, true, I2C_TIMEOUT_US)) {
      I2C1->CR1 |= I2C_CR1_STOP;
      return false;
    }
    *buffer++ = (uint8_t)I2C1->DR;
    length--;
  }

  if (!hw_i2c_wait_flag(&I2C1->SR1, I2C_SR1_BTF, true, I2C_TIMEOUT_US)) {
    I2C1->CR1 |= I2C_CR1_STOP;
    return false;
  }
  I2C1->CR1 &= ~I2C_CR1_ACK;
  __disable_irq();
  *buffer++ = (uint8_t)I2C1->DR;
  I2C1->CR1 |= I2C_CR1_STOP;
  __enable_irq();
  *buffer++ = (uint8_t)I2C1->DR;
  if (!hw_i2c_wait_flag(&I2C1->SR1, I2C_SR1_RXNE, true, I2C_TIMEOUT_US)) {
    return false;
  }
  *buffer = (uint8_t)I2C1->DR;
  I2C1->CR1 |= I2C_CR1_ACK;
  return true;
}

static bool hmc5883l_init(void)
{
  return hw_i2c_write_register(HMC5883L_ADDR, HMC_REG_CONFIG_A, 0x70U) &&
         hw_i2c_write_register(HMC5883L_ADDR, HMC_REG_CONFIG_B, 0x20U) &&
         hw_i2c_write_register(HMC5883L_ADDR, HMC_REG_MODE, 0x00U);
}

static bool hmc5883l_read(float *mx, float *my, float *mz)
{
  uint8_t buf[6];

  if (!hw_i2c_read_registers(HMC5883L_ADDR, HMC_REG_DATA_X_MSB, buf, sizeof(buf))) {
    return false;
  }

  *mx = (float)(int16_t)((buf[0] << 8) | buf[1]) / 1090.0f;
  *mz = (float)(int16_t)((buf[2] << 8) | buf[3]) / 1090.0f;
  *my = (float)(int16_t)((buf[4] << 8) | buf[5]) / 1090.0f;
  return true;
}

static float wrap_heading_deg(float heading_deg_value)
{
  while (heading_deg_value >= 360.0f) {
    heading_deg_value -= 360.0f;
  }
  while (heading_deg_value < 0.0f) {
    heading_deg_value += 360.0f;
  }
  return heading_deg_value;
}

static float heading_error_deg(float target_deg, float current_deg)
{
  float error = wrap_heading_deg(target_deg) - wrap_heading_deg(current_deg);

  while (error > 180.0f) {
    error -= 360.0f;
  }
  while (error < -180.0f) {
    error += 360.0f;
  }

  return error;
}

static float compute_heading_deg(float mx, float my, float mz, float pitch_deg, float roll_deg)
{
  const float pitch = pitch_deg * DEG_TO_RAD;
  const float roll = roll_deg * DEG_TO_RAD;
  const float mx2 = (mx * cosf(pitch)) + (mz * sinf(pitch));
  const float my2 = (mx * sinf(roll) * sinf(pitch)) +
                    (my * cosf(roll)) -
                    (mz * sinf(roll) * cosf(pitch));
  float yaw = atan2f(-my2, mx2) * RAD_TO_DEG;

  return wrap_heading_deg(yaw);
}

#if USE_BARO
static bool bmp180_read_calib(void)
{
  uint8_t buf[22];

  if (!hw_i2c_read_registers(BMP180_ADDR, BMP_REG_CALIB, buf, sizeof(buf))) {
    return false;
  }

  bmp180_calib.ac1 = (int16_t)((buf[0] << 8) | buf[1]);
  bmp180_calib.ac2 = (int16_t)((buf[2] << 8) | buf[3]);
  bmp180_calib.ac3 = (int16_t)((buf[4] << 8) | buf[5]);
  bmp180_calib.ac4 = (uint16_t)((buf[6] << 8) | buf[7]);
  bmp180_calib.ac5 = (uint16_t)((buf[8] << 8) | buf[9]);
  bmp180_calib.ac6 = (uint16_t)((buf[10] << 8) | buf[11]);
  bmp180_calib.b1 = (int16_t)((buf[12] << 8) | buf[13]);
  bmp180_calib.b2 = (int16_t)((buf[14] << 8) | buf[15]);
  bmp180_calib.mb = (int16_t)((buf[16] << 8) | buf[17]);
  bmp180_calib.mc = (int16_t)((buf[18] << 8) | buf[19]);
  bmp180_calib.md = (int16_t)((buf[20] << 8) | buf[21]);
  return true;
}

static bool bmp180_start_temp(void)
{
  return hw_i2c_write_register(BMP180_ADDR, BMP_REG_CTRL, BMP_CMD_TEMP);
}

static bool bmp180_read_ut(int32_t *ut)
{
  uint8_t buf[2];

  if (!hw_i2c_read_registers(BMP180_ADDR, BMP_REG_DATA, buf, sizeof(buf))) {
    return false;
  }

  *ut = (int32_t)((buf[0] << 8) | buf[1]);
  return true;
}

static bool bmp180_start_pressure(void)
{
  return hw_i2c_write_register(BMP180_ADDR, BMP_REG_CTRL, BMP_CMD_PRES + (BMP_OSS << 6));
}

static bool bmp180_read_up(int32_t *up)
{
  uint8_t buf[3];

  if (!hw_i2c_read_registers(BMP180_ADDR, BMP_REG_DATA, buf, sizeof(buf))) {
    return false;
  }

  *up = (int32_t)(((uint32_t)buf[0] << 16) | ((uint32_t)buf[1] << 8) | buf[2]) >> (8 - BMP_OSS);
  return true;
}

static void bmp180_compute(int32_t ut, int32_t up, float *temperature_c, float *pressure_hpa)
{
  int32_t x1;
  int32_t x2;
  int32_t x3;
  int32_t b3;
  int32_t b6;
  int32_t pressure;
  uint32_t b4;
  uint32_t b7;

  x1 = ((ut - (int32_t)bmp180_calib.ac6) * (int32_t)bmp180_calib.ac5) >> 15;
  x2 = ((int32_t)bmp180_calib.mc << 11) / (x1 + (int32_t)bmp180_calib.md);
  baro_b5 = x1 + x2;
  *temperature_c = (float)((baro_b5 + 8) >> 4) / 10.0f;

  b6 = baro_b5 - 4000;
  x1 = ((int32_t)bmp180_calib.b2 * ((b6 * b6) >> 12)) >> 11;
  x2 = ((int32_t)bmp180_calib.ac2 * b6) >> 11;
  x3 = x1 + x2;
  b3 = ((((int32_t)bmp180_calib.ac1 * 4 + x3) << BMP_OSS) + 2) / 4;
  x1 = ((int32_t)bmp180_calib.ac3 * b6) >> 13;
  x2 = ((int32_t)bmp180_calib.b1 * ((b6 * b6) >> 12)) >> 16;
  x3 = (x1 + x2 + 2) >> 2;
  b4 = ((uint32_t)bmp180_calib.ac4 * (uint32_t)(x3 + 32768)) >> 15;
  b7 = (uint32_t)(up - b3) * (50000UL >> BMP_OSS);
  pressure = (b7 < 0x80000000UL) ? (int32_t)((b7 * 2U) / b4) : (int32_t)((b7 / b4) * 2U);
  x1 = (pressure >> 8) * (pressure >> 8);
  x1 = (x1 * 3038) >> 16;
  x2 = (-7357 * pressure) >> 16;
  pressure += (x1 + x2 + 3791) >> 4;

  *pressure_hpa = (float)pressure / 100.0f;
}

static float compute_altitude_m(float pressure_hpa)
{
  return 44330.0f * (1.0f - powf(pressure_hpa / SEA_LEVEL_HPA, 0.1903f));
}
#endif

static bool detect_rf_loss_pattern(const RcCommand *command)
{
  return (command->raw[2] <= RF_PRESET_THROTTLE_MAX_US) &&
         (pulse_distance_us(command->raw[0], RF_PRESET_CENTER_US) <= RF_PRESET_WINDOW_US) &&
         (pulse_distance_us(command->raw[1], RF_PRESET_CENTER_US) <= RF_PRESET_WINDOW_US) &&
         (pulse_distance_us(command->raw[3], RF_PRESET_CENTER_US) <= RF_PRESET_WINDOW_US);
}

static void update_aux_sensors(uint32_t now_ms)
{
  if ((uint32_t)(now_ms - last_mag_update_ms) >= MAG_UPDATE_MS) {
    float mx;
    float my;
    float mz;
    float heading_source_x;
    float heading_source_y;
    float heading_source_z;

    last_mag_update_ms = now_ms;
    if (hmc5883l_read(&mx, &my, &mz)) {
      float heading_error_to_estimate;
      bool heading_jump_ok = true;

      if ((mag_lpf_x == 0.0f) && (mag_lpf_y == 0.0f) && (mag_lpf_z == 0.0f)) {
        mag_lpf_x = mx;
        mag_lpf_y = my;
        mag_lpf_z = mz;
      } else {
        mag_lpf_x = lpf_apply(mag_lpf_x, mx, MAG_RAW_LPF_ALPHA);
        mag_lpf_y = lpf_apply(mag_lpf_y, my, MAG_RAW_LPF_ALPHA);
        mag_lpf_z = lpf_apply(mag_lpf_z, mz, MAG_RAW_LPF_ALPHA);
      }

      heading_source_x = mag_lpf_x - mag_offset_x;
      heading_source_y = mag_lpf_y - mag_offset_y;
      heading_source_z = mag_lpf_z - mag_offset_z;
      rotate_mag_axes(&heading_source_x, &heading_source_y, &heading_source_z);

      mag_field_strength = sqrtf((heading_source_x * heading_source_x) +
                                 (heading_source_y * heading_source_y) +
                                 (heading_source_z * heading_source_z));
      if (mag_field_filtered <= 0.0f) {
        mag_field_filtered = mag_field_strength;
      } else {
        mag_field_filtered = lpf_apply(mag_field_filtered, mag_field_strength, 0.08f);
      }

      const float computed_heading = compute_heading_deg(heading_source_x,
                                                         heading_source_y,
                                                         heading_source_z,
                                                         attitude.pitch_deg,
                                                         attitude.roll_deg);

      mag_heading_jump = mag_heading_valid ? fabsf(heading_error_deg(computed_heading, mag_heading_deg)) : 0.0f;
      heading_jump_ok = (!mag_heading_valid) || (mag_heading_jump <= MAG_HEADING_JUMP_DEG);

      mag_fail_streak = 0U;
      mag_ready = true;
      mag_raw_x = mag_lpf_x;
      mag_raw_y = mag_lpf_y;
      mag_raw_z = mag_lpf_z;
      mag_heading_deg = computed_heading;

      if ((mag_field_strength >= MAG_FIELD_MIN_GAUSS) &&
          (mag_field_strength <= MAG_FIELD_MAX_GAUSS) &&
          heading_jump_ok &&
          mag_calibrated) {
        if (mag_good_since_ms == 0U) {
          mag_good_since_ms = now_ms;
        }
        mag_usable = ((uint32_t)(now_ms - mag_good_since_ms) >= MAG_HEALTH_RECOVER_MS);
      } else {
        mag_good_since_ms = 0U;
        mag_usable = false;
      }

      mag_correction_allowed = mag_usable &&
                               (fabsf(attitude.roll_deg) <= MAG_CORRECTION_MAX_TILT_DEG) &&
                               (fabsf(attitude.pitch_deg) <= MAG_CORRECTION_MAX_TILT_DEG) &&
                               (fabsf(gyro_lpf_x) <= MAG_CORRECTION_MAX_RP_RATE_DPS) &&
                               (fabsf(gyro_lpf_y) <= MAG_CORRECTION_MAX_RP_RATE_DPS) &&
                               (accel_trust >= MAG_CORRECTION_MIN_ACCEL_TRUST) &&
                               (fabsf(throttle_delta_norm) <= MAG_CORRECTION_MAX_THR_DELTA);

      if (mag_correction_allowed) {
        heading_error_to_estimate = heading_error_deg(computed_heading, attitude.yaw_deg);
        if (!armed && !heading_hold_engaged) {
          attitude.yaw_deg = computed_heading;
        } else {
          attitude.yaw_deg = wrap_heading_deg(attitude.yaw_deg +
                                              (heading_error_to_estimate *
                                               clampf(MAG_YAW_CORRECTION_GAIN * ((float)MAG_UPDATE_MS / 1000.0f),
                                                      0.0f,
                                                      0.04f)));
        }
        heading_deg = attitude.yaw_deg;
      }

      mag_heading_valid = true;
    } else if (++mag_fail_streak >= MAG_FAIL_LIMIT) {
      mag_ready = false;
      mag_usable = false;
      mag_correction_allowed = false;
      mag_good_since_ms = 0U;
    }
  }

  #if USE_BARO
  if ((uint32_t)(now_ms - last_baro_update_ms) >= BARO_UPDATE_MS) {
    if (baro_state == BARO_STATE_IDLE) {
      if (bmp180_start_temp()) {
        baro_state = BARO_STATE_WAIT_TEMP;
        baro_deadline_ms = now_ms + BMP180_CONV_TIME_MS;
      } else if (++baro_fail_streak >= BARO_FAIL_LIMIT) {
        baro_ready = false;
      }
    }

    last_baro_update_ms = now_ms;
  }

  if ((baro_state == BARO_STATE_WAIT_TEMP) && ((int32_t)(now_ms - baro_deadline_ms) >= 0)) {
    if (bmp180_read_ut(&baro_ut) && bmp180_start_pressure()) {
      baro_state = BARO_STATE_WAIT_PRESS;
      baro_deadline_ms = now_ms + BMP180_CONV_TIME_MS;
    } else if (++baro_fail_streak >= BARO_FAIL_LIMIT) {
      baro_ready = false;
      baro_state = BARO_STATE_IDLE;
    }
  }

  if ((baro_state == BARO_STATE_WAIT_PRESS) && ((int32_t)(now_ms - baro_deadline_ms) >= 0)) {
    int32_t up;

    if (bmp180_read_up(&up)) {
      float absolute_altitude_m;

      bmp180_compute(baro_ut, up, &baro_temperature_c, &baro_pressure_hpa);

      if (baro_pressure_filtered_hpa <= 0.0f) {
        baro_pressure_filtered_hpa = baro_pressure_hpa;
      } else {
        baro_pressure_filtered_hpa = lpf_apply(baro_pressure_filtered_hpa,
                                               baro_pressure_hpa,
                                               BARO_PRESSURE_LPF_ALPHA);
      }

      absolute_altitude_m = compute_altitude_m(baro_pressure_filtered_hpa);
      if (!baro_ref_valid && (baro_ref_samples == 0U)) {
        baro_altitude_filtered_m = absolute_altitude_m;
      } else {
        baro_altitude_filtered_m = lpf_apply(baro_altitude_filtered_m,
                                             absolute_altitude_m,
                                             BARO_ALTITUDE_LPF_ALPHA);
      }

      baro_fail_streak = 0U;
      baro_ready = true;
      baro_altitude_m = absolute_altitude_m;
      if (!baro_ref_valid) {
        baro_ref_accum_m += baro_altitude_filtered_m;
        baro_ref_samples++;
        if (baro_ref_samples >= BARO_REF_SETTLE_SAMPLES) {
          baro_altitude_ref_m = baro_ref_accum_m / (float)baro_ref_samples;
          baro_relative_altitude_m = 0.0f;
          baro_ref_valid = true;
        }
      } else {
        baro_relative_altitude_m = baro_altitude_filtered_m - baro_altitude_ref_m;
      }
    } else if (++baro_fail_streak >= BARO_FAIL_LIMIT) {
      baro_ready = false;
    }

    baro_state = BARO_STATE_IDLE;
  }
  #endif
}

static float apply_throttle_slew(float target_norm, float dt, bool reset_state)
{
  const float rising_step = THROTTLE_SLEW_UP_PER_S * dt;
  const float falling_step = THROTTLE_SLEW_DOWN_PER_S * dt;

  if (reset_state) {
    throttle_command_norm = clampf(target_norm, 0.0f, 1.0f);
    return throttle_command_norm;
  }

  if (target_norm > throttle_command_norm) {
    throttle_command_norm = fminf(target_norm, throttle_command_norm + rising_step);
  } else {
    throttle_command_norm = fmaxf(target_norm, throttle_command_norm - falling_step);
  }

  return throttle_command_norm;
}

static float clampf(float value, float min_value, float max_value)
{
  if (value < min_value) {
    return min_value;
  }
  if (value > max_value) {
    return max_value;
  }
  return value;
}

static float apply_expo(float value, float expo)
{
  return (value * (1.0f - expo)) + (value * value * value * expo);
}

static float lpf_alpha(float cutoff_hz, float dt)
{
  const float rc = 1.0f / (2.0f * 3.14159265f * cutoff_hz);
  return clampf(dt / (rc + dt), 0.0f, 1.0f);
}

static float lpf_apply(float previous, float input, float alpha)
{
  return previous + alpha * (input - previous);
}

static uint16_t pulse_distance_us(uint16_t a, uint16_t b)
{
  return (a >= b) ? (a - b) : (b - a);
}

static float normalize_centered(uint16_t pulse_us,
                                uint16_t min_us,
                                float center_us,
                                uint16_t max_us,
                                float sign)
{
  float centered = (float)pulse_us - center_us;
  float span;

  if (fabsf(centered) < (float)RC_DEADBAND_US) {
    centered = 0.0f;
  } else if (centered > 0.0f) {
    centered -= (float)RC_DEADBAND_US;
  } else {
    centered += (float)RC_DEADBAND_US;
  }

  if (centered >= 0.0f) {
    span = (float)max_us - center_us - (float)RC_DEADBAND_US;
  } else {
    span = center_us - (float)min_us - (float)RC_DEADBAND_US;
  }

  if (span < 1.0f) {
    span = 1.0f;
  }

  centered /= span;
  centered = clampf(centered, -1.0f, 1.0f);

  return apply_expo(centered, STICK_EXPO) * sign;
}

static void update_rc_center_learning(RcCommand *command, uint32_t now_ms)
{
  const bool sticks_near_center =
    (fabsf((float)command->raw[0] - rc_roll_center_runtime) <= (float)RC_CENTER_LEARN_WINDOW_US) &&
    (fabsf((float)command->raw[1] - rc_pitch_center_runtime) <= (float)RC_CENTER_LEARN_WINDOW_US);

  if (armed || !command->valid || !command->throttle_low || !sticks_near_center ||
      command->yaw_arm_request || command->yaw_disarm_request) {
    rc_center_learn_ms = 0U;
    return;
  }

  if (rc_center_learn_ms == 0U) {
    rc_center_learn_ms = now_ms;
    return;
  }

  if ((uint32_t)(now_ms - rc_center_learn_ms) < RC_CENTER_LEARN_MIN_MS) {
    return;
  }

  rc_roll_center_runtime = lpf_apply(rc_roll_center_runtime, (float)command->raw[0], RC_CENTER_LEARN_ALPHA);
  rc_pitch_center_runtime = lpf_apply(rc_pitch_center_runtime, (float)command->raw[1], RC_CENTER_LEARN_ALPHA);
  rc_yaw_center_runtime = (float)RC_YAW_CENTER_US;
}

static float normalize_throttle(uint16_t pulse_us)
{
  return clampf(((float)pulse_us - (float)RC_THROTTLE_MIN_US) /
                (float)(RC_THROTTLE_MAX_US - RC_THROTTLE_MIN_US),
                0.0f,
                1.0f);
}

static float apply_throttle_curve(float value)
{
  const float clamped = clampf(value, 0.0f, 1.0f);

  return ((1.0f - THROTTLE_EXPO) * clamped) + (THROTTLE_EXPO * clamped * clamped);
}

static void rotate_xy(float *x, float *y)
{
  const float original_x = *x;
  const float original_y = *y;

  switch (SENSOR_ROTATION) {
    case SENSOR_ROTATION_90:
      *x = -original_y;
      *y = original_x;
      break;

    case SENSOR_ROTATION_180:
      *x = -original_x;
      *y = -original_y;
      break;

    case SENSOR_ROTATION_270:
      *x = original_y;
      *y = -original_x;
      break;

    case SENSOR_ROTATION_0:
    default:
      break;
  }
}

static void rotate_mag_axes(float *x, float *y, float *z)
{
  const float original_x = *x * MAG_X_SIGN;
  const float original_y = *y * MAG_Y_SIGN;

  *z *= MAG_Z_SIGN;

  switch (MAG_ROTATION) {
    case SENSOR_ROTATION_90:
      *x = -original_y;
      *y = original_x;
      break;

    case SENSOR_ROTATION_180:
      *x = -original_x;
      *y = -original_y;
      break;

    case SENSOR_ROTATION_270:
      *x = original_y;
      *y = -original_x;
      break;

    case SENSOR_ROTATION_0:
    default:
      *x = original_x;
      *y = original_y;
      break;
  }
}

static float control_roll_accel_deg(const ImuSample *sample)
{
  return atan2f(-sample->ax,
                sqrtf(sample->ay * sample->ay + sample->az * sample->az)) * RAD_TO_DEG;
}

static float control_pitch_accel_deg(const ImuSample *sample)
{
  return atan2f(sample->ay, sample->az) * RAD_TO_DEG;
}

static float control_roll_rate_dps(const ImuSample *sample)
{
  return sample->gy;
}

static float control_pitch_rate_dps(const ImuSample *sample)
{
  return sample->gx;
}

static float control_yaw_rate_dps(const ImuSample *sample)
{
  return sample->gz;
}

static float hover_trim_scale(float throttle_norm)
{
  if (throttle_norm <= HOVER_TRIM_START_THROTTLE) {
    return 0.0f;
  }

  return clampf((throttle_norm - HOVER_TRIM_START_THROTTLE) /
                (HOVER_TRIM_FULL_THROTTLE - HOVER_TRIM_START_THROTTLE),
                0.0f,
                1.0f);
}

static void pid_reset(PidAxis *pid)
{
  pid->integrator = 0.0f;
  pid->prev_measurement = 0.0f;
  pid->d_filter = 0.0f;
}

static void reset_all_pids(void)
{
  pid_reset(&pid_roll);
  pid_reset(&pid_pitch);
  pid_reset(&pid_yaw);
  yaw_bias_output = 0.0f;
}

static float pid_update(PidAxis *pid, float setpoint, float measurement, float dt, bool enable_integrator)
{
  const float error = setpoint - measurement;
  const float safe_dt = fmaxf(dt, 0.0005f);
  const float derivative = (pid->prev_measurement - measurement) / safe_dt;
  const float d_alpha = lpf_alpha(PID_D_FILTER_CUTOFF_HZ, safe_dt);
  float candidate_integrator = pid->integrator;
  float output;

  pid->prev_measurement = measurement;
  pid->d_filter += d_alpha * (derivative - pid->d_filter);

  if (enable_integrator) {
    candidate_integrator += pid->ki * error * safe_dt;
    candidate_integrator = clampf(candidate_integrator,
                                  -pid->integrator_limit,
                                  pid->integrator_limit);
  } else {
    candidate_integrator *= 0.80f;
  }

  output = (pid->kp * error) + candidate_integrator + (pid->kd * pid->d_filter);

  if ((fabsf(output) < pid->output_limit) ||
      ((output > pid->output_limit) && (error < 0.0f)) ||
      ((output < -pid->output_limit) && (error > 0.0f))) {
    pid->integrator = candidate_integrator;
  }

  output = (pid->kp * error) + pid->integrator + (pid->kd * pid->d_filter);
  return clampf(output, -pid->output_limit, pid->output_limit);
}

static bool imu_write_reg(uint8_t reg, uint8_t value)
{
  for (uint8_t attempt = 0U; attempt < 3U; attempt++) {
    if (hw_i2c_write_register(MPU6050_ADDR, reg, value)) {
      return true;
    }
    hw_i2c1_init();
  }
  return false;
}

static bool imu_read_regs(uint8_t reg, uint8_t *buffer, uint16_t length)
{
  for (uint8_t attempt = 0U; attempt < 3U; attempt++) {
    if (hw_i2c_read_registers(MPU6050_ADDR, reg, buffer, length)) {
      return true;
    }
    hw_i2c1_init();
  }
  return false;
}

static bool mpu6050_init(void)
{
  uint8_t who_am_i = 0U;

  if (!imu_read_regs(MPU_REG_WHO_AM_I, &who_am_i, 1U)) {
    return false;
  }

  if ((who_am_i != 0x68U) && (who_am_i != 0x70U)) {
    return false;
  }

  if (!imu_write_reg(MPU_REG_PWR_MGMT_1, 0x00U)) {
    return false;
  }
  HAL_Delay(100U);

  if (!imu_write_reg(MPU_REG_INT_PIN_CFG, 0x02U)) {
    return false;
  }

  if (!imu_write_reg(MPU_REG_SMPLRT_DIV, 0x03U)) {
    return false;
  }
  if (!imu_write_reg(MPU_REG_CONFIG, 0x03U)) {
    return false;
  }
  if (!imu_write_reg(MPU_REG_GYRO_CONFIG, 0x08U)) {
    return false;
  }
  if (!imu_write_reg(MPU_REG_ACCEL_CONFIG, 0x08U)) {
    return false;
  }

  return true;
}

static bool mpu6050_enable_bypass(void)
{
  return imu_write_reg(MPU_REG_INT_PIN_CFG, 0x02U);
}

static bool mpu6050_read_raw(ImuSample *sample)
{
  uint8_t raw[14];
  int16_t accel_x_raw;
  int16_t accel_y_raw;
  int16_t accel_z_raw;
  int16_t gyro_x_raw;
  int16_t gyro_y_raw;
  int16_t gyro_z_raw;

  if (!imu_read_regs(MPU_REG_ACCEL_XOUT_H, raw, sizeof(raw))) {
    return false;
  }

  accel_x_raw = (int16_t)((raw[0] << 8) | raw[1]);
  accel_y_raw = (int16_t)((raw[2] << 8) | raw[3]);
  accel_z_raw = (int16_t)((raw[4] << 8) | raw[5]);

  gyro_x_raw = (int16_t)((raw[8] << 8) | raw[9]);
  gyro_y_raw = (int16_t)((raw[10] << 8) | raw[11]);
  gyro_z_raw = (int16_t)((raw[12] << 8) | raw[13]);

  sample->ax = (float)accel_x_raw / MPU_ACCEL_SCALE_4G;
  sample->ay = (float)accel_y_raw / MPU_ACCEL_SCALE_4G;
  sample->az = (float)accel_z_raw / MPU_ACCEL_SCALE_4G;

  sample->gx = ((float)gyro_x_raw / MPU_GYRO_SCALE_500DPS) - gyro_bias_x_dps;
  sample->gy = ((float)gyro_y_raw / MPU_GYRO_SCALE_500DPS) - gyro_bias_y_dps;
  sample->gz = (((float)gyro_z_raw / MPU_GYRO_SCALE_500DPS) - gyro_bias_z_dps) * GYRO_Z_SIGN;

  rotate_xy(&sample->ax, &sample->ay);
  rotate_xy(&sample->gx, &sample->gy);

  return true;
}

static bool mpu6050_read_filtered(ImuSample *sample, float dt)
{
  ImuSample raw_sample;
  const float gyro_alpha = lpf_alpha(GYRO_LPF_HZ, dt);
  const float accel_alpha = lpf_alpha(ACCEL_LPF_HZ, dt);

  if (!mpu6050_read_raw(&raw_sample)) {
    return false;
  }

  gyro_lpf_x = lpf_apply(gyro_lpf_x, raw_sample.gx, gyro_alpha);
  gyro_lpf_y = lpf_apply(gyro_lpf_y, raw_sample.gy, gyro_alpha);
  gyro_lpf_z = lpf_apply(gyro_lpf_z, raw_sample.gz, gyro_alpha);

  accel_lpf_x = lpf_apply(accel_lpf_x, raw_sample.ax, accel_alpha);
  accel_lpf_y = lpf_apply(accel_lpf_y, raw_sample.ay, accel_alpha);
  accel_lpf_z = lpf_apply(accel_lpf_z, raw_sample.az, accel_alpha);

  sample->ax = accel_lpf_x;
  sample->ay = accel_lpf_y;
  sample->az = accel_lpf_z;
  sample->gx = gyro_lpf_x;
  sample->gy = gyro_lpf_y;
  sample->gz = gyro_lpf_z;

  return true;
}

static bool mpu6050_calibrate(void)
{
  ImuSample sample;
  ImuSample level_sample = {0.0f, 0.0f, 1.0f, 0.0f, 0.0f, 0.0f};
  float gyro_x_sum = 0.0f;
  float gyro_y_sum = 0.0f;
  float gyro_z_sum = 0.0f;
  float accel_x_sum = 0.0f;
  float accel_y_sum = 0.0f;
  float accel_z_sum = 0.0f;

  uart_log("[IMU] Keep frame still and level for calibration...\r\n");

  for (uint32_t i = 0U; i < GYRO_CALIB_SAMPLES; i++) {
    if (!mpu6050_read_raw(&sample)) {
      return false;
    }
    gyro_x_sum += sample.gx;
    gyro_y_sum += sample.gy;
    gyro_z_sum += sample.gz;
    HAL_Delay(2U);
  }

  gyro_bias_x_dps = gyro_x_sum / (float)GYRO_CALIB_SAMPLES;
  gyro_bias_y_dps = gyro_y_sum / (float)GYRO_CALIB_SAMPLES;
  gyro_bias_z_dps = gyro_z_sum / (float)GYRO_CALIB_SAMPLES;

  for (uint32_t i = 0U; i < ACCEL_CALIB_SAMPLES; i++) {
    if (!mpu6050_read_raw(&sample)) {
      return false;
    }
    accel_x_sum += sample.ax;
    accel_y_sum += sample.ay;
    accel_z_sum += sample.az;
    HAL_Delay(2U);
  }

  accel_x_sum /= (float)ACCEL_CALIB_SAMPLES;
  accel_y_sum /= (float)ACCEL_CALIB_SAMPLES;
  accel_z_sum /= (float)ACCEL_CALIB_SAMPLES;

  {
    const float gyro_bias_mag = sqrtf((gyro_bias_x_dps * gyro_bias_x_dps) +
                                      (gyro_bias_y_dps * gyro_bias_y_dps) +
                                      (gyro_bias_z_dps * gyro_bias_z_dps));
    const float accel_mag = sqrtf((accel_x_sum * accel_x_sum) +
                                  (accel_y_sum * accel_y_sum) +
                                  (accel_z_sum * accel_z_sum));

    if ((gyro_bias_mag > 35.0f) || (accel_mag < 0.70f) || (accel_mag > 1.30f)) {
      uart_log("[IMU] Calibration rejected. Keep frame still and level.\r\n");
      return false;
    }
  }

  level_sample.ax = accel_x_sum;
  level_sample.ay = accel_y_sum;
  level_sample.az = accel_z_sum;

  accel_roll_trim = control_roll_accel_deg(&level_sample) + SENSOR_LEVEL_ROLL_OFFSET_DEG;
  accel_pitch_trim = control_pitch_accel_deg(&level_sample) + SENSOR_LEVEL_PITCH_OFFSET_DEG;

  gyro_lpf_x = 0.0f;
  gyro_lpf_y = 0.0f;
  gyro_lpf_z = 0.0f;
  accel_lpf_x = 0.0f;
  accel_lpf_y = 0.0f;
  accel_lpf_z = 1.0f;
  attitude.roll_deg = 0.0f;
  attitude.pitch_deg = 0.0f;
  attitude.yaw_deg = heading_deg;
  accel_norm = 1.0f;
  accel_trust = 1.0f;

  (void)snprintf(uart_buf,
                 sizeof(uart_buf),
                 "[IMU] Calibration done. accel trim=%ld/%ld hover trim=%ld/%ld\r\n",
                 (long)(accel_roll_trim * 10.0f),
                 (long)(accel_pitch_trim * 10.0f),
                 (long)(HOVER_ROLL_TRIM_DEG * 10.0f),
                 (long)(HOVER_PITCH_TRIM_DEG * 10.0f));
  uart_log(uart_buf);
  return true;
}

static void update_attitude(const ImuSample *sample, float dt)
{
  const float accel_roll = control_roll_accel_deg(sample) - accel_roll_trim;
  const float accel_pitch = control_pitch_accel_deg(sample) - accel_pitch_trim;
  const float accel_correction_step = clampf(ACCEL_CORRECTION_GAIN * dt, 0.0f, 0.08f);

  accel_norm = sqrtf(sample->ax * sample->ax + sample->ay * sample->ay + sample->az * sample->az);
  accel_trust = 1.0f - clampf(fabsf(accel_norm - 1.0f) / ACCEL_TRUST_MAX_ERROR_G, 0.0f, 1.0f);

  attitude.roll_deg += control_roll_rate_dps(sample) * dt;
  attitude.pitch_deg += control_pitch_rate_dps(sample) * dt;
  attitude.yaw_deg = wrap_heading_deg(attitude.yaw_deg + (control_yaw_rate_dps(sample) * dt));

  if (accel_trust > 0.0f) {
    attitude.roll_deg += (accel_roll - attitude.roll_deg) * accel_correction_step * accel_trust;
    attitude.pitch_deg += (accel_pitch - attitude.pitch_deg) * accel_correction_step * accel_trust;
  }

  heading_deg = attitude.yaw_deg;
}

static bool receiver_read_command(RcCommand *command, uint32_t now_ms)
{
  uint32_t ages[RC_CHANNELS];
  float roll_raw;
  float pitch_raw;
  float yaw_raw;
  float throttle_raw;

  __disable_irq();
  for (uint8_t i = 0U; i < RC_CHANNELS; i++) {
    command->raw[i] = rc_pulse_us[i];
    ages[i] = rc_last_update_ms[i];
  }
  __enable_irq();

  command->valid = true;
  for (uint8_t i = 0U; i < RC_CHANNELS; i++) {
    if ((ages[i] == 0U) ||
        ((uint32_t)(now_ms - ages[i]) > RX_TIMEOUT_MS) ||
        (command->raw[i] < RC_VALID_MIN_US) ||
        (command->raw[i] > RC_VALID_MAX_US)) {
      command->valid = false;
      break;
    }
  }

  if (!command->valid) {
    command->rf_loss_detected = false;
    command->throttle_low = true;
    command->yaw_arm_request = false;
    command->yaw_disarm_request = false;
    command->throttle_norm = 0.0f;
    command->roll_cmd = 0.0f;
    command->pitch_cmd = 0.0f;
    command->yaw_cmd = 0.0f;
    return false;
  }

  command->throttle_low = (command->raw[2] <= THROTTLE_LOW_US);
  command->yaw_arm_request = command->throttle_low &&
                              (command->raw[3] >= ARM_YAW_HIGH_US) &&
                              (fabsf((float)command->raw[0] - rc_roll_center_runtime) <= (float)ARM_STICK_CENTER_WINDOW_US) &&
                              (fabsf((float)command->raw[1] - rc_pitch_center_runtime) <= (float)ARM_STICK_CENTER_WINDOW_US);
  command->yaw_disarm_request = command->throttle_low &&
                                 (command->raw[3] <= DISARM_YAW_LOW_US) &&
                                 (fabsf((float)command->raw[0] - rc_roll_center_runtime) <= (float)ARM_STICK_CENTER_WINDOW_US) &&
                                 (fabsf((float)command->raw[1] - rc_pitch_center_runtime) <= (float)ARM_STICK_CENTER_WINDOW_US);

  update_rc_center_learning(command, now_ms);

  roll_raw = normalize_centered(command->raw[0],
                                RC_ROLL_MIN_US,
                                rc_roll_center_runtime,
                                RC_ROLL_MAX_US,
                                RC_ROLL_SIGN);
  pitch_raw = normalize_centered(command->raw[1],
                                 RC_PITCH_MIN_US,
                                 rc_pitch_center_runtime,
                                 RC_PITCH_MAX_US,
                                 RC_PITCH_SIGN);
  throttle_raw = normalize_throttle(command->raw[2]);
  yaw_raw = normalize_centered(command->raw[3],
                               RC_YAW_MIN_US,
                               rc_yaw_center_runtime,
                               RC_YAW_MAX_US,
                               RC_YAW_SIGN);

  rc_roll_filtered = lpf_apply(rc_roll_filtered, roll_raw, RC_STICK_ALPHA);
  rc_pitch_filtered = lpf_apply(rc_pitch_filtered, pitch_raw, RC_STICK_ALPHA);
  rc_yaw_filtered = lpf_apply(rc_yaw_filtered, yaw_raw, RC_YAW_ALPHA);
  rc_throttle_filtered = lpf_apply(rc_throttle_filtered, throttle_raw, RC_THROTTLE_ALPHA);
  command->throttle_norm = apply_throttle_curve(rc_throttle_filtered);
  command->roll_cmd = rc_roll_filtered;
  command->pitch_cmd = rc_pitch_filtered;
  if (command->throttle_low) {
    rc_yaw_filtered = 0.0f;
    command->yaw_cmd = 0.0f;
  } else {
    command->yaw_cmd = rc_yaw_filtered;
  }
  command->rf_loss_detected = detect_rf_loss_pattern(command);
  if (!command->rf_loss_detected) {
    last_pilot_throttle_norm = command->throttle_norm;
  }

  return true;
}

static bool command_is_centered(const RcCommand *command)
{
  return (fabsf(command->roll_cmd) <= 0.15f) &&
         (fabsf(command->pitch_cmd) <= 0.15f) &&
         (fabsf(command->yaw_cmd) <= 0.20f);
}

static void enter_rf_failsafe(uint32_t now_ms)
{
  failsafe_mode = FAILSAFE_HOLD;
  failsafe_state_ms = now_ms;
  rf_recover_ms = 0U;
  land_detect_ms = 0U;
  failsafe_throttle_norm = clampf(last_pilot_throttle_norm,
                                  FAILSAFE_DESCEND_MIN,
                                  0.65f);
  reset_all_pids();
  uart_log("[SAFE] RF lost. Holding level.\r\n");
}

static void update_failsafe_state(const RcCommand *command,
                                  bool sensors_ok,
                                  const ImuSample *sample,
                                  bool sample_valid,
                                  uint32_t now_ms,
                                  float dt)
{
  bool preset_loss_confirmed = false;
  bool receiver_lost;
  const bool low_motion = sample_valid &&
                          (fabsf(attitude.roll_deg) <= FAILSAFE_LAND_ATTITUDE_DEG) &&
                          (fabsf(attitude.pitch_deg) <= FAILSAFE_LAND_ATTITUDE_DEG) &&
                          (fabsf(control_roll_rate_dps(sample)) <= FAILSAFE_LAND_RATE_DPS) &&
                          (fabsf(control_pitch_rate_dps(sample)) <= FAILSAFE_LAND_RATE_DPS) &&
                          (fabsf(control_yaw_rate_dps(sample)) <= FAILSAFE_LAND_RATE_DPS);

  if (command->rf_loss_detected) {
    if (rf_preset_detect_ms == 0U) {
      rf_preset_detect_ms = now_ms;
    } else if ((uint32_t)(now_ms - rf_preset_detect_ms) >= RF_PRESET_DETECT_MS) {
      preset_loss_confirmed = true;
    }
  } else {
    rf_preset_detect_ms = 0U;
  }

  receiver_lost = (!command->valid) || preset_loss_confirmed;

  if (!sensors_ok) {
    failsafe_active = true;
    failsafe_mode = FAILSAFE_NONE;
    if (armed) {
      uart_log("[SAFE] IMU unavailable. Emergency disarm.\r\n");
    }
    armed = false;
    reset_all_pids();
    return;
  }

  if (!armed) {
    failsafe_active = receiver_lost;
    failsafe_mode = FAILSAFE_NONE;
    rf_recover_ms = 0U;
    rf_preset_detect_ms = 0U;
    land_detect_ms = 0U;
    return;
  }

  if (receiver_lost) {
    failsafe_active = true;
    rf_recover_ms = 0U;

    if (failsafe_mode == FAILSAFE_NONE || failsafe_mode == FAILSAFE_RECOVER) {
      if (last_pilot_throttle_norm > FAILSAFE_AIRBORNE_THROTTLE) {
        enter_rf_failsafe(now_ms);
      } else {
        uart_log("[SAFE] RF lost on ground. Disarming.\r\n");
        armed = false;
        failsafe_mode = FAILSAFE_NONE;
        rf_preset_detect_ms = 0U;
        reset_all_pids();
      }
      return;
    }

    if ((failsafe_mode == FAILSAFE_HOLD) &&
        ((uint32_t)(now_ms - failsafe_state_ms) >= FAILSAFE_HOLD_MS)) {
      failsafe_mode = FAILSAFE_DESCEND;
      failsafe_state_ms = now_ms;
      uart_log("[SAFE] Controlled descent active.\r\n");
    }

    if (failsafe_mode == FAILSAFE_DESCEND) {
      const float descend_rate = (failsafe_throttle_norm > FAILSAFE_DESCEND_SPLIT) ?
                                 FAILSAFE_DESCEND_RATE_HIGH :
                                 FAILSAFE_DESCEND_RATE_LOW;

      failsafe_throttle_norm = fmaxf(FAILSAFE_DESCEND_FINAL,
                                     failsafe_throttle_norm - (descend_rate * dt));

      if ((failsafe_throttle_norm <= (FAILSAFE_DESCEND_FINAL + 0.01f)) && low_motion) {
        if (land_detect_ms == 0U) {
          land_detect_ms = now_ms;
        } else if ((uint32_t)(now_ms - land_detect_ms) >= FAILSAFE_LAND_STABLE_MS) {
          uart_log("[SAFE] Landing detected. Disarming.\r\n");
          armed = false;
          failsafe_mode = FAILSAFE_NONE;
          failsafe_active = false;
          reset_all_pids();
          stop_all_motors();
        }
      } else {
        land_detect_ms = 0U;
      }
    }

    return;
  }

  if ((failsafe_mode == FAILSAFE_HOLD) || (failsafe_mode == FAILSAFE_DESCEND)) {
    failsafe_active = true;
    if (rf_recover_ms == 0U) {
      rf_recover_ms = now_ms;
    } else if (((uint32_t)(now_ms - rf_recover_ms) >= FAILSAFE_RECOVER_VALID_MS) &&
               command_is_centered(command)) {
      failsafe_mode = FAILSAFE_RECOVER;
      failsafe_state_ms = now_ms;
      uart_log("[SAFE] RF restored. Blending pilot control.\r\n");
    }
    return;
  }

  if (failsafe_mode == FAILSAFE_RECOVER) {
    failsafe_active = true;
    if ((uint32_t)(now_ms - failsafe_state_ms) >= FAILSAFE_RECOVER_BLEND_MS) {
      failsafe_mode = FAILSAFE_NONE;
      failsafe_active = false;
      rf_recover_ms = 0U;
      rf_preset_detect_ms = 0U;
      uart_log("[SAFE] Pilot control restored.\r\n");
    }
    return;
  }

  failsafe_active = false;
}

static void update_arming_state(const RcCommand *command, bool sensors_ok, uint32_t now_ms)
{
  if (!sensors_ok) {
    armed = false;
    arm_request_ms = 0U;
    disarm_request_ms = 0U;
    reset_all_pids();
    return;
  }

  if (!command->valid || (failsafe_mode != FAILSAFE_NONE)) {
    arm_request_ms = 0U;
    disarm_request_ms = 0U;
    return;
  }

  if (command->yaw_disarm_request) {
    if (disarm_request_ms == 0U) {
      disarm_request_ms = now_ms;
    } else if ((uint32_t)(now_ms - disarm_request_ms) >= DISARM_HOLD_MS) {
      if (armed) {
        uart_log("[ARM] Disarmed by stick command.\r\n");
      }
      armed = false;
      heading_hold_engaged = false;
      rc_yaw_filtered = 0.0f;
      arm_request_ms = 0U;
      reset_all_pids();
    }
  } else {
    disarm_request_ms = 0U;
  }

  if (armed) {
    return;
  }

  if (!command->yaw_arm_request) {
    arm_request_ms = 0U;
    return;
  }

  if (arm_request_ms == 0U) {
    arm_request_ms = now_ms;
  } else if ((uint32_t)(now_ms - arm_request_ms) >= ARM_HOLD_MS) {
    armed = true;
    disarm_request_ms = 0U;
    rc_yaw_filtered = 0.0f;
    heading_hold_ref_deg = attitude.yaw_deg;
    heading_hold_engaged = false;
    last_heading_hold_ms = now_ms;
    reset_all_pids();
    uart_log("[ARM] Armed.\r\n");
  }
}

static void build_control_command(const RcCommand *pilot_command,
                                  RcCommand *control_command,
                                  uint32_t now_ms,
                                  float dt)
{
  float target_throttle_norm;

  *control_command = *pilot_command;

  target_throttle_norm = pilot_command->throttle_norm;

  if ((failsafe_mode == FAILSAFE_NONE) || !armed) {
    control_command->throttle_norm = apply_throttle_slew(target_throttle_norm, dt, !armed);
    return;
  }

  control_command->valid = true;
  control_command->yaw_arm_request = false;
  control_command->yaw_disarm_request = false;

  if ((failsafe_mode == FAILSAFE_HOLD) || (failsafe_mode == FAILSAFE_DESCEND)) {
    control_command->roll_cmd = 0.0f;
    control_command->pitch_cmd = 0.0f;
    control_command->yaw_cmd = 0.0f;
    target_throttle_norm = failsafe_throttle_norm;
  } else if (failsafe_mode == FAILSAFE_RECOVER) {
    const float blend = clampf((float)((uint32_t)(now_ms - failsafe_state_ms)) /
                               (float)FAILSAFE_RECOVER_BLEND_MS,
                               0.0f,
                               1.0f);

    control_command->roll_cmd = pilot_command->roll_cmd * blend;
    control_command->pitch_cmd = pilot_command->pitch_cmd * blend;
    control_command->yaw_cmd = pilot_command->yaw_cmd * blend;
    target_throttle_norm = failsafe_throttle_norm +
                           ((pilot_command->throttle_norm - failsafe_throttle_norm) * blend);
  }

  control_command->throttle_norm = apply_throttle_slew(target_throttle_norm, dt, false);

  control_command->throttle_low = (control_command->throttle_norm <= 0.03f);

  if (failsafe_mode == FAILSAFE_DESCEND) {
    failsafe_throttle_norm = control_command->throttle_norm;
  }

  (void)dt;
}

static void motor_set_us(uint8_t motor_index, uint16_t pulse_us)
{
  const uint16_t limited = (uint16_t)clampf((float)pulse_us, (float)MOTOR_STOP_US, (float)MOTOR_MAX_US);
  motor_output_us[motor_index] = limited;

  switch (motor_index) {
    case 0U:
      __HAL_TIM_SET_COMPARE(&htim2, TIM_CHANNEL_1, limited);
      break;
    case 1U:
      __HAL_TIM_SET_COMPARE(&htim2, TIM_CHANNEL_2, limited);
      break;
    case 2U:
      __HAL_TIM_SET_COMPARE(&htim2, TIM_CHANNEL_3, limited);
      break;
    case 3U:
      __HAL_TIM_SET_COMPARE(&htim2, TIM_CHANNEL_4, limited);
      break;
    default:
      break;
  }
}

static void motors_write_all(uint16_t m1, uint16_t m2, uint16_t m3, uint16_t m4)
{
  motor_set_us(0U, m1);
  motor_set_us(1U, m2);
  motor_set_us(2U, m3);
  motor_set_us(3U, m4);
}

static void stop_all_motors(void)
{
  motors_write_all(MOTOR_STOP_US, MOTOR_STOP_US, MOTOR_STOP_US, MOTOR_STOP_US);
}

static void mix_motor_outputs(float throttle_base,
                              float roll_output,
                              float pitch_output,
                              float yaw_output)
{
  float corrections[4];
  float rp_corrections[4];
  float yaw_corrections[4];
  float positive_demand = 0.0f;
  float negative_demand = 0.0f;
  float scale = 1.0f;
  const float yaw_mix_output = yaw_output * YAW_MIX_SIGN;
  const float upper_room = (float)MOTOR_MAX_US - throttle_base;
  const float lower_room = throttle_base - (float)MOTOR_IDLE_US;

  rp_corrections[0] = roll_output - pitch_output;
  rp_corrections[1] = -roll_output - pitch_output;
  rp_corrections[2] = -roll_output + pitch_output;
  rp_corrections[3] = roll_output + pitch_output;
  yaw_corrections[0] = yaw_mix_output;
  yaw_corrections[1] = -yaw_mix_output;
  yaw_corrections[2] = yaw_mix_output;
  yaw_corrections[3] = -yaw_mix_output;

  mixer_yaw_scale = 1.0f;
  mixer_rp_scale = 1.0f;
  mixer_saturated = false;

  for (uint8_t i = 0U; i < 4U; i++) {
    corrections[i] = rp_corrections[i] + yaw_corrections[i];
  }

  for (uint8_t i = 0U; i < 4U; i++) {
    if (corrections[i] > positive_demand) {
      positive_demand = corrections[i];
    }
    if (-corrections[i] > negative_demand) {
      negative_demand = -corrections[i];
    }
  }

  if ((positive_demand > upper_room) && (positive_demand > 0.0f)) {
    scale = fminf(scale, upper_room / positive_demand);
  }

  if ((negative_demand > lower_room) && (negative_demand > 0.0f)) {
    scale = fminf(scale, lower_room / negative_demand);
  }

  if (scale < 0.999f) {
    float low = 0.0f;
    float high = 1.0f;
    mixer_saturated = true;

    for (uint8_t step = 0U; step < 8U; step++) {
      const float mid = (low + high) * 0.5f;
      float pos = 0.0f;
      float neg = 0.0f;

      for (uint8_t i = 0U; i < 4U; i++) {
        const float value = rp_corrections[i] + (yaw_corrections[i] * mid);
        if (value > pos) {
          pos = value;
        }
        if (-value > neg) {
          neg = -value;
        }
      }

      if ((pos <= upper_room) && (neg <= lower_room)) {
        low = mid;
      } else {
        high = mid;
      }
    }

    mixer_yaw_scale = (fabsf(yaw_output) > 1.0f) ? fmaxf(low, YAW_AUTHORITY_FLOOR) : low;
    low = 0.0f;
    high = 1.0f;
    for (uint8_t step = 0U; step < 8U; step++) {
      const float mid = (low + high) * 0.5f;
      float pos = 0.0f;
      float neg = 0.0f;

      for (uint8_t i = 0U; i < 4U; i++) {
        const float value = (rp_corrections[i] * mid) + (yaw_corrections[i] * mixer_yaw_scale);
        if (value > pos) {
          pos = value;
        }
        if (-value > neg) {
          neg = -value;
        }
      }

      if ((pos <= upper_room) && (neg <= lower_room)) {
        low = mid;
      } else {
        high = mid;
      }
    }

    mixer_rp_scale = low;

    for (uint8_t i = 0U; i < 4U; i++) {
      corrections[i] = (rp_corrections[i] * mixer_rp_scale) +
                       (yaw_corrections[i] * mixer_yaw_scale);
    }
    scale = 1.0f;
  }

  motors_write_all((uint16_t)clampf(throttle_base + corrections[0] * scale,
                                    (float)MOTOR_IDLE_US,
                                    (float)MOTOR_MAX_US),
                   (uint16_t)clampf(throttle_base + corrections[1] * scale,
                                    (float)MOTOR_IDLE_US,
                                    (float)MOTOR_MAX_US),
                   (uint16_t)clampf(throttle_base + corrections[2] * scale,
                                    (float)MOTOR_IDLE_US,
                                    (float)MOTOR_MAX_US),
                   (uint16_t)clampf(throttle_base + corrections[3] * scale,
                                    (float)MOTOR_IDLE_US,
                                    (float)MOTOR_MAX_US));
}

static void run_flight_control(const RcCommand *command, const ImuSample *sample, float dt)
{
  float roll_outer_kp;
  float pitch_outer_kp;
  float desired_roll_angle;
  float desired_pitch_angle;
  float desired_roll_rate;
  float desired_pitch_rate;
  float desired_yaw_rate;
  float roll_output;
  float pitch_output;
  float yaw_output;
  float throttle_base;
  const bool enable_integrator = (command->throttle_norm > 0.10f);
  const float trim_scale = hover_trim_scale(command->throttle_norm);
  const bool roll_pitch_stick_active = (fabsf(command->roll_cmd) > HEADING_HOLD_MAX_RP_STICK) ||
                                       (fabsf(command->pitch_cmd) > HEADING_HOLD_MAX_RP_STICK);
  const bool roll_pitch_moving = (fabsf(control_roll_rate_dps(sample)) > HEADING_HOLD_MAX_RP_RATE_DPS) ||
                                 (fabsf(control_pitch_rate_dps(sample)) > HEADING_HOLD_MAX_RP_RATE_DPS);
  const bool roll_pitch_tilted = (fabsf(attitude.roll_deg) > HEADING_HOLD_MAX_TILT_DEG) ||
                                 (fabsf(attitude.pitch_deg) > HEADING_HOLD_MAX_TILT_DEG);
  const bool roll_pitch_maneuver = roll_pitch_stick_active || roll_pitch_moving || roll_pitch_tilted;
  const bool sticks_centered_for_takeoff = (fabsf(command->roll_cmd) <= TAKEOFF_ASSIST_STICK_THRESH) &&
                                           (fabsf(command->pitch_cmd) <= TAKEOFF_ASSIST_STICK_THRESH) &&
                                           (fabsf(command->yaw_cmd) <= HEADING_HOLD_YAW_DEADBAND);
  const bool yaw_control_active = (!command->throttle_low) &&
                                  (command->throttle_norm >= YAW_CONTROL_MIN_THROTTLE);

  if (!armed || (failsafe_active && (failsafe_mode == FAILSAFE_NONE))) {
    throttle_delta_norm = 0.0f;
    last_control_throttle_norm = 0.0f;
    yaw_dynamic_damping_output = 0.0f;
    yaw_throttle_feedforward_output = 0.0f;
    yaw_feedforward_output = 0.0f;
    yaw_maneuver_bias_output = 0.0f;
    yaw_bias_output *= YAW_BIAS_DECAY;
    heading_hold_limited_error_deg = 0.0f;
    throttle_rate_norm_s = 0.0f;
    takeoff_assist_scale = 0.0f;
    roll_pitch_dynamic = false;
    stop_all_motors();
    return;
  }

  throttle_delta_norm = command->throttle_norm - last_control_throttle_norm;
  throttle_rate_norm_s = throttle_delta_norm / fmaxf(dt, 0.001f);
  last_control_throttle_norm = command->throttle_norm;
  roll_pitch_dynamic = roll_pitch_maneuver;

  takeoff_assist_scale = 0.0f;
  if (sticks_centered_for_takeoff &&
      (command->throttle_norm >= TAKEOFF_ASSIST_MIN_THROTTLE) &&
      (command->throttle_norm <= TAKEOFF_ASSIST_MAX_THROTTLE)) {
    takeoff_assist_scale = clampf((TAKEOFF_ASSIST_MAX_THROTTLE - command->throttle_norm) /
                                  (TAKEOFF_ASSIST_MAX_THROTTLE - TAKEOFF_ASSIST_MIN_THROTTLE),
                                  0.0f,
                                  1.0f);
  }

  desired_roll_angle = (command->roll_cmd * MAX_ANGLE_DEG) +
                       (HOVER_ROLL_TRIM_DEG * trim_scale) +
                       (TAKEOFF_ROLL_TRIM_DEG * takeoff_assist_scale);
  desired_pitch_angle = (command->pitch_cmd * MAX_ANGLE_DEG) +
                        (HOVER_PITCH_TRIM_DEG * trim_scale) +
                        (TAKEOFF_PITCH_TRIM_DEG * takeoff_assist_scale);

  roll_outer_kp = ANGLE_OUTER_KP +
                  ((fabsf(command->roll_cmd) <= CENTER_BRAKE_STICK_THRESH) ? CENTER_BRAKE_KP_BOOST : 0.0f) +
                  (TAKEOFF_ASSIST_KP_BOOST * takeoff_assist_scale);
  pitch_outer_kp = ANGLE_OUTER_KP +
                   ((fabsf(command->pitch_cmd) <= CENTER_BRAKE_STICK_THRESH) ? CENTER_BRAKE_KP_BOOST : 0.0f) +
                   (TAKEOFF_ASSIST_KP_BOOST * takeoff_assist_scale);

  desired_roll_rate = clampf((desired_roll_angle - attitude.roll_deg) * roll_outer_kp,
                             -MAX_ANGLE_RATE_DPS,
                             MAX_ANGLE_RATE_DPS);
  desired_pitch_rate = clampf((desired_pitch_angle - attitude.pitch_deg) * pitch_outer_kp,
                              -MAX_ANGLE_RATE_DPS,
                              MAX_ANGLE_RATE_DPS);
  heading_hold_allowed = yaw_control_active && (command->throttle_norm >= HEADING_HOLD_MIN_THROTTLE);
  yaw_maneuver_scale = 1.0f;

  if (yaw_control_active && (fabsf(command->yaw_cmd) > HEADING_HOLD_YAW_EXIT_DB)) {
    desired_yaw_rate = command->yaw_cmd * MAX_YAW_RATE_DPS;
    heading_hold_ref_deg = attitude.yaw_deg;
    heading_hold_engaged = false;
    last_heading_hold_ms = HAL_GetTick();
  } else if (heading_hold_allowed) {
    const uint32_t now_ms = HAL_GetTick();

    if (!heading_hold_engaged &&
        (fabsf(command->yaw_cmd) <= HEADING_HOLD_YAW_DEADBAND) &&
        ((uint32_t)(now_ms - last_heading_hold_ms) >= HEADING_HOLD_RELEASE_MS)) {
      heading_hold_ref_deg = attitude.yaw_deg;
      heading_hold_engaged = true;
    }

    if (heading_hold_engaged) {
      heading_hold_limited_error_deg = clampf(heading_error_deg(heading_hold_ref_deg, attitude.yaw_deg),
                                             -HEADING_HOLD_ERROR_LIMIT_DEG,
                                             HEADING_HOLD_ERROR_LIMIT_DEG);
      desired_yaw_rate = clampf(heading_hold_limited_error_deg * HEADING_HOLD_KP,
                                -HEADING_HOLD_RATE_LIMIT_DPS,
                                HEADING_HOLD_RATE_LIMIT_DPS);
    } else {
      heading_hold_limited_error_deg = 0.0f;
      desired_yaw_rate = 0.0f;
    }
  } else {
    heading_hold_ref_deg = attitude.yaw_deg;
    heading_hold_engaged = false;
    last_heading_hold_ms = HAL_GetTick();
    desired_yaw_rate = 0.0f;
    heading_hold_limited_error_deg = 0.0f;
  }

  if (roll_pitch_maneuver && (fabsf(command->yaw_cmd) <= HEADING_HOLD_YAW_DEADBAND)) {
    const float stick_amount = fmaxf(fabsf(command->roll_cmd), fabsf(command->pitch_cmd));
    const float tilt_amount = fmaxf(fabsf(attitude.roll_deg), fabsf(attitude.pitch_deg)) / MAX_ANGLE_DEG;
    const float rate_amount = fmaxf(fabsf(control_roll_rate_dps(sample)),
                                    fabsf(control_pitch_rate_dps(sample))) / MAX_ANGLE_RATE_DPS;
    const float maneuver_amount = clampf(fmaxf(stick_amount, fmaxf(tilt_amount, rate_amount)),
                                         0.0f,
                                         1.0f);
    yaw_maneuver_scale = 1.0f - clampf((maneuver_amount - YAW_MANEUEVER_STICK_THRESH) /
                                       (1.0f - YAW_MANEUEVER_STICK_THRESH),
                                       0.0f,
                                       1.0f) * (1.0f - YAW_MANEUVER_AUTHORITY_MIN);
  }

  last_desired_yaw_rate = desired_yaw_rate;
  last_gyro_x_dps = control_pitch_rate_dps(sample);
  last_gyro_y_dps = control_roll_rate_dps(sample);
  last_heading_error_deg = heading_hold_engaged ? heading_hold_limited_error_deg : 0.0f;
  last_gyro_z_dps = control_yaw_rate_dps(sample);

  if (mixer_saturated && (mixer_yaw_scale < 0.85f) && heading_hold_engaged) {
    pid_yaw.integrator *= YAW_SAT_INTEGRATOR_DECAY;
  }

  roll_output = pid_update(&pid_roll, desired_roll_rate, control_roll_rate_dps(sample), dt, enable_integrator);
  pitch_output = pid_update(&pid_pitch, desired_pitch_rate, control_pitch_rate_dps(sample), dt, enable_integrator);
  if (yaw_control_active) {
    yaw_output = pid_update(&pid_yaw,
                            desired_yaw_rate,
                            control_yaw_rate_dps(sample),
                            dt,
                            enable_integrator);
  } else {
    pid_reset(&pid_yaw);
    yaw_output = 0.0f;
  }

  yaw_dynamic_damping_output = 0.0f;
  yaw_throttle_feedforward_output = 0.0f;
  yaw_feedforward_output = 0.0f;
  yaw_maneuver_bias_output = 0.0f;
  if (yaw_control_active && (fabsf(command->yaw_cmd) <= HEADING_HOLD_YAW_DEADBAND)) {
    if (heading_hold_allowed || roll_pitch_maneuver ||
        (fabsf(throttle_delta_norm) > MAG_CORRECTION_MAX_THR_DELTA)) {
      const float yaw_damping_kp = YAW_DYNAMIC_DAMPING_KP +
                                   (command->throttle_norm * YAW_DYNAMIC_DAMPING_THR_KP) +
                                   (roll_pitch_maneuver ? YAW_DYNAMIC_DAMPING_RP_KP : 0.0f);
      yaw_dynamic_damping_output = -control_yaw_rate_dps(sample) * yaw_damping_kp;
    }
    if (roll_pitch_maneuver) {
      const float rp_stick_amount = fmaxf(fabsf(command->roll_cmd), fabsf(command->pitch_cmd));
      const float rp_output_amount = fmaxf(fabsf(roll_output), fabsf(pitch_output));
      const float rp_rate_amount = fmaxf(fabsf(control_roll_rate_dps(sample)),
                                        fabsf(control_pitch_rate_dps(sample)));
      const float rp_throttle_scale = 1.0f + (command->throttle_norm * YAW_RP_BIAS_THR_GAIN);
      const float rp_bias_raw = (rp_stick_amount * YAW_RP_MANEUVER_BIAS_FF) +
                                (rp_output_amount * YAW_RP_OUTPUT_BIAS_FF) +
                                (rp_rate_amount * YAW_RP_RATE_BIAS_FF);
      yaw_maneuver_bias_output = clampf(rp_bias_raw * rp_throttle_scale,
                                        -YAW_RP_BIAS_LIMIT,
                                        YAW_RP_BIAS_LIMIT);
    }
    yaw_throttle_feedforward_output = (command->throttle_norm * YAW_THROTTLE_FF) +
                                      (command->throttle_norm * command->throttle_norm * YAW_THROTTLE_HIGH_FF) +
                                      (throttle_rate_norm_s * YAW_THROTTLE_DELTA_FF) +
                                      (takeoff_assist_scale * YAW_TAKEOFF_BIAS_FF);
    yaw_feedforward_output = yaw_throttle_feedforward_output +
                             (command->roll_cmd * YAW_ROLL_COUPLING_FF) +
                             (command->pitch_cmd * YAW_PITCH_COUPLING_FF) +
                             yaw_maneuver_bias_output;
    if ((fabsf(control_yaw_rate_dps(sample)) <= YAW_BIAS_LEARN_MAX_RATE_DPS) &&
        (command->throttle_norm >= YAW_BIAS_LEARN_MIN_THROTTLE) &&
        (mixer_yaw_scale > 0.80f) &&
        !mixer_saturated) {
      yaw_bias_output += (desired_yaw_rate - control_yaw_rate_dps(sample)) *
                         YAW_BIAS_LEARN_GAIN * dt;
      yaw_bias_output = clampf(yaw_bias_output, -YAW_BIAS_LIMIT, YAW_BIAS_LIMIT);
    } else {
      yaw_bias_output *= mixer_saturated ? YAW_BIAS_SAT_DECAY : YAW_BIAS_DECAY;
    }
    yaw_output += yaw_dynamic_damping_output + yaw_feedforward_output + yaw_bias_output;
    yaw_output = clampf(yaw_output, -pid_yaw.output_limit, pid_yaw.output_limit);
  } else {
    yaw_bias_output *= YAW_BIAS_DECAY;
  }
  last_roll_pid_output = roll_output;
  last_pitch_pid_output = pitch_output;
  last_yaw_pid_output = yaw_output;

  throttle_base = (float)MOTOR_IDLE_US +
                  (command->throttle_norm * (float)((MOTOR_MAX_US - MOTOR_HEADROOM_US) - MOTOR_IDLE_US));
  throttle_tilt_boost = 0.0f;
  if (command->throttle_norm >= TILT_THROTTLE_MIN) {
    const float roll_cos = cosf(attitude.roll_deg * DEG_TO_RAD);
    const float pitch_cos = cosf(attitude.pitch_deg * DEG_TO_RAD);
    const float vertical_factor = clampf(roll_cos * pitch_cos, 0.70f, 1.0f);
    throttle_tilt_boost = clampf((1.0f / vertical_factor) - 1.0f,
                                 0.0f,
                                 TILT_THROTTLE_MAX_BOOST);
    throttle_base += throttle_tilt_boost * command->throttle_norm *
                     (float)((MOTOR_MAX_US - MOTOR_HEADROOM_US) - MOTOR_IDLE_US);
    throttle_base = clampf(throttle_base, (float)MOTOR_IDLE_US, (float)(MOTOR_MAX_US - MOTOR_HEADROOM_US));
  }

  mix_motor_outputs(throttle_base, roll_output, pitch_output, yaw_output);
}

static void log_status(const RcCommand *command)
{
  const long roll10 = (long)(attitude.roll_deg * 10.0f);
  const long pitch10 = (long)(attitude.pitch_deg * 10.0f);
  const long roll_cmd100 = (long)(command->roll_cmd * 100.0f);
  const long pitch_cmd100 = (long)(command->pitch_cmd * 100.0f);
  const long yaw_cmd100 = (long)(command->yaw_cmd * 100.0f);
  const long throttle_cmd100 = (long)(command->throttle_norm * 100.0f);
  const long failsafe_throttle100 = (long)(failsafe_throttle_norm * 100.0f);
  const long heading10 = (long)(heading_deg * 10.0f);
  const long heading_ref10 = (long)(heading_hold_ref_deg * 10.0f);
  const long mag_heading10 = (long)(mag_heading_deg * 10.0f);
  const long magx100 = (long)(mag_raw_x * 100.0f);
  const long magy100 = (long)(mag_raw_y * 100.0f);
  const long magz100 = (long)(mag_raw_z * 100.0f);
  const long accel_norm100 = (long)(accel_norm * 100.0f);
  const long mag_field100 = (long)(mag_field_strength * 100.0f);
  const long tilt_boost100 = (long)(throttle_tilt_boost * 100.0f);
  const long takeoff_assist100 = (long)(takeoff_assist_scale * 100.0f);
  const long pid_roll10 = (long)(last_roll_pid_output * 10.0f);
  const long pid_pitch10 = (long)(last_pitch_pid_output * 10.0f);
  const long pid_yaw10 = (long)(last_yaw_pid_output * 10.0f);
  const long desired_yaw10 = (long)(last_desired_yaw_rate * 10.0f);
  const long gyro_x10 = (long)(last_gyro_x_dps * 10.0f);
  const long gyro_y10 = (long)(last_gyro_y_dps * 10.0f);
  const long gyro_z10 = (long)(last_gyro_z_dps * 10.0f);
  const long heading_error10 = (long)(last_heading_error_deg * 10.0f);
  const long throttle_delta1000 = (long)(throttle_delta_norm * 1000.0f);
  const long throttle_rate100 = (long)(throttle_rate_norm_s * 100.0f);
  const long yaw_dynamic10 = (long)(yaw_dynamic_damping_output * 10.0f);
  const long yaw_throttle10 = (long)(yaw_throttle_feedforward_output * 10.0f);
  const long yaw_feedforward10 = (long)(yaw_feedforward_output * 10.0f);
  const long yaw_bias10 = (long)(yaw_maneuver_bias_output * 10.0f);
  const long yaw_learn_bias10 = (long)(yaw_bias_output * 10.0f);
  const long yaw_scale100 = (long)(mixer_yaw_scale * 100.0f);
  const long rp_scale100 = (long)(mixer_rp_scale * 100.0f);
  const long yaw_maneuver100 = (long)(yaw_maneuver_scale * 100.0f);

  (void)snprintf(uart_buf,
                 sizeof(uart_buf),
                   "ARM=%u FS=%u FM=%u RL=%u TL=%u AR=%u DR=%u RAW=%u/%u/%u/%u CMD=%ld/%ld/%ld/%ld FTH=%ld CTR=%ld/%ld/%ld THR=%u-%u ANG=%ld/%ld HDG=%ld REF=%ld HH=%u HA=%u MAG=%u MU=%u MA=%u MC=%u MH=%ld MF=%ld ACC=%ld TB=%ld TA=%ld TD=%ld TR=%ld DYR=%ld GX=%ld GY=%ld GZ=%ld HE=%ld YD=%ld YT=%ld YF=%ld YB=%ld YBL=%ld PID=%ld/%ld/%ld SAT=%u YS=%ld RS=%ld YM=%ld MX=%ld/%ld/%ld M=%u/%u/%u/%u\r\n",
                 armed ? 1U : 0U,
                 failsafe_active ? 1U : 0U,
                 (unsigned int)failsafe_mode,
                 command->rf_loss_detected ? 1U : 0U,
                 command->throttle_low ? 1U : 0U,
                 command->yaw_arm_request ? 1U : 0U,
                 command->yaw_disarm_request ? 1U : 0U,
                 (unsigned int)command->raw[0],
                 (unsigned int)command->raw[1],
                 (unsigned int)command->raw[2],
                 (unsigned int)command->raw[3],
                 roll_cmd100,
                 pitch_cmd100,
                 yaw_cmd100,
                 throttle_cmd100,
                 failsafe_throttle100,
                  (long)rc_roll_center_runtime,
                  (long)rc_pitch_center_runtime,
                  (long)rc_yaw_center_runtime,
                  (unsigned int)RC_THROTTLE_MIN_US,
                  (unsigned int)RC_THROTTLE_MAX_US,
                  roll10,
                  pitch10,
                  heading10,
                  heading_ref10,
                  heading_hold_engaged ? 1U : 0U,
                  heading_hold_allowed ? 1U : 0U,
                  mag_ready ? 1U : 0U,
                  mag_usable ? 1U : 0U,
                  mag_correction_allowed ? 1U : 0U,
                  mag_calibrated ? 1U : 0U,
                  mag_heading10,
                  mag_field100,
                  accel_norm100,
                  tilt_boost100,
                  takeoff_assist100,
                  throttle_delta1000,
                  throttle_rate100,
                   desired_yaw10,
                   gyro_x10,
                   gyro_y10,
                   gyro_z10,
                   heading_error10,
                   yaw_dynamic10,
                   yaw_throttle10,
                   yaw_feedforward10,
                    yaw_bias10,
                    yaw_learn_bias10,
                  pid_roll10,
                  pid_pitch10,
                  pid_yaw10,
                  mixer_saturated ? 1U : 0U,
                  yaw_scale100,
                  rp_scale100,
                  yaw_maneuver100,
                  magx100,
                  magy100,
                 magz100,
                 (unsigned int)motor_output_us[0],
                 (unsigned int)motor_output_us[1],
                 (unsigned int)motor_output_us[2],
                 (unsigned int)motor_output_us[3]);

  uart_log(uart_buf);
}

void HAL_TIM_IC_CaptureCallback(TIM_HandleTypeDef *htim)
{
  uint8_t index;
  uint32_t tim_channel;
  uint32_t capture;
  uint32_t pulse_width;
  uint32_t tick_ms;

  if (htim->Instance != TIM3) {
    return;
  }

  if (htim->Channel == HAL_TIM_ACTIVE_CHANNEL_1) {
    index = 0U;
    tim_channel = TIM_CHANNEL_1;
  } else if (htim->Channel == HAL_TIM_ACTIVE_CHANNEL_2) {
    index = 1U;
    tim_channel = TIM_CHANNEL_2;
  } else if (htim->Channel == HAL_TIM_ACTIVE_CHANNEL_3) {
    index = 2U;
    tim_channel = TIM_CHANNEL_3;
  } else if (htim->Channel == HAL_TIM_ACTIVE_CHANNEL_4) {
    index = 3U;
    tim_channel = TIM_CHANNEL_4;
  } else {
    return;
  }

  capture = HAL_TIM_ReadCapturedValue(htim, tim_channel);

  if (rc_edge_state[index] == 0U) {
    rc_rise_ticks[index] = capture;
    rc_edge_state[index] = 1U;
    __HAL_TIM_SET_CAPTUREPOLARITY(htim, tim_channel, TIM_INPUTCHANNELPOLARITY_FALLING);
    return;
  }

  if (capture >= rc_rise_ticks[index]) {
    pulse_width = capture - rc_rise_ticks[index];
  } else {
    pulse_width = (65535U - rc_rise_ticks[index]) + capture + 1U;
  }

  rc_edge_state[index] = 0U;
  __HAL_TIM_SET_CAPTUREPOLARITY(htim, tim_channel, TIM_INPUTCHANNELPOLARITY_RISING);

  if ((pulse_width >= 800U) && (pulse_width <= 2200U)) {
    rc_pulse_us[index] = (uint16_t)pulse_width;
    tick_ms = HAL_GetTick();
    rc_last_update_ms[index] = (tick_ms == 0U) ? 1U : tick_ms;
  }
}
/* USER CODE END 0 */

/**
  * @brief  The application entry point.
  * @retval int
  */
int main(void)
{
  uint32_t last_loop_cycles;
  uint32_t next_loop_cycles;
  uint32_t loop_period_cycles;
  uint32_t last_log_ms = 0U;

  HAL_Init();
  SystemClock_Config();

  MX_GPIO_Init();
  MX_TIM2_Init();
  MX_TIM3_Init();
  MX_USART1_UART_Init();

  dwt_init();
  hw_i2c1_init();
  set_status_led(false);

  HAL_TIM_PWM_Start(&htim2, TIM_CHANNEL_1);
  HAL_TIM_PWM_Start(&htim2, TIM_CHANNEL_2);
  HAL_TIM_PWM_Start(&htim2, TIM_CHANNEL_3);
  HAL_TIM_PWM_Start(&htim2, TIM_CHANNEL_4);
  stop_all_motors();

  HAL_TIM_IC_Start_IT(&htim3, TIM_CHANNEL_1);
  HAL_TIM_IC_Start_IT(&htim3, TIM_CHANNEL_2);
  HAL_TIM_IC_Start_IT(&htim3, TIM_CHANNEL_3);
  HAL_TIM_IC_Start_IT(&htim3, TIM_CHANNEL_4);

  uart_log("\r\n========================================\r\n");
  uart_log(" Blue Pill UAV Flight Controller\r\n");
  uart_log(" TIM2 motors / TIM3 receiver / ANGLE\r\n");
  uart_log(" Props OFF during setup and tests\r\n");
  uart_log("========================================\r\n");

  HAL_Delay(300U);
  imu_ready = mpu6050_init();
  if (imu_ready) {
    imu_ready = mpu6050_calibrate();
  }

  if (!imu_ready) {
    uart_log("[IMU] MPU6050 init/calibration failed. Flight locked.\r\n");
  }

  mag_ready = imu_ready && mpu6050_enable_bypass() && hmc5883l_init();
  if (mag_ready) {
    uart_log("[MAG] HMC5883L ready.\r\n");
  } else {
    uart_log("[MAG] HMC5883L init failed. Heading hold disabled.\r\n");
  }

  uart_log("[ESC] Holding 1000us for ESC boot.\r\n");
  HAL_Delay(2000U);
  uart_log("[ARM] Throttle low + yaw right hold 3s = arm\r\n");
  uart_log("[ARM] Throttle low + yaw left hold  3s = disarm\r\n");

  loop_period_cycles = SystemCoreClock / LOOP_HZ;
  last_loop_cycles = dwt_cycles32();
  next_loop_cycles = last_loop_cycles + loop_period_cycles;

  while (1) {
    const uint32_t now_cycles = dwt_cycles32();
    const uint32_t now_ms = HAL_GetTick();
    const uint32_t log_period_ms = armed ? LOG_PERIOD_ARMED_MS : LOG_PERIOD_DISARMED_MS;
    RcCommand command = {0};

    update_status_led();
    receiver_read_command(&command, now_ms);

    if ((uint32_t)(now_ms - last_log_ms) >= log_period_ms) {
      last_log_ms = now_ms;
      log_status(&command);
    }

    if ((int32_t)(now_cycles - next_loop_cycles) < 0) {
      continue;
    }

    while ((int32_t)(now_cycles - next_loop_cycles) >= 0) {
      next_loop_cycles += loop_period_cycles;
    }

    {
      const float dt = (float)((uint32_t)(now_cycles - last_loop_cycles)) / (float)SystemCoreClock;
      ImuSample sample = {0.0f, 0.0f, 1.0f, 0.0f, 0.0f, 0.0f};
      RcCommand control_command = {0};
      bool sensors_ok = imu_ready;
      bool sample_valid = false;

      last_loop_cycles = now_cycles;

      if (dt <= 0.0f || dt > 0.02f) {
        stop_all_motors();
        reset_all_pids();
        next_loop_cycles = now_cycles + loop_period_cycles;
        continue;
      }

      if (imu_ready) {
        if (mpu6050_read_filtered(&sample, dt)) {
          imu_fail_streak = 0U;
          sample_valid = true;
          update_attitude(&sample, dt);
          update_aux_sensors(now_ms);
        } else {
          imu_fail_streak++;
          if (imu_fail_streak >= IMU_FAIL_LIMIT) {
            imu_ready = false;
            sensors_ok = false;
            uart_log("[IMU] Repeated read failure. Flight locked.\r\n");
          }
        }
      } else {
        sensors_ok = false;
      }

      update_failsafe_state(&command, sensors_ok, &sample, sample_valid, now_ms, dt);
      update_arming_state(&command, sensors_ok, now_ms);

      if (!sensors_ok) {
        stop_all_motors();
        continue;
      }

      if (!sample_valid) {
        stop_all_motors();
        continue;
      }

      build_control_command(&command, &control_command, now_ms, dt);

      if (!control_command.valid) {
        stop_all_motors();
        continue;
      }

      run_flight_control(&control_command, &sample, dt);
    }
  }
}

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
