HuynhMinhThuan1310/UAV-FLIGHT-CONTROLLER/mach-UAV-main/firmware/PWM_ADC_TIMER/PWM_ADC_TIMER.ioc

Mcu.UserName=STM32F103C8Tx
PA15.Signal=S_TIM2_CH1_ETR
PA4.Signal=ADCx_IN4
PA5.Signal=ADCx_IN5
PA6.Signal=ADCx_IN6
PA7.Signal=ADCx_IN7
PB10.Signal=S_TIM2_CH3
PB11.Signal=S_TIM2_CH4
PB3.Signal=S_TIM2_CH2
PC13-TAMPER-RTC.Signal=GPIO_Output
PD0-OSC_IN.Signal=RCC_OSC_IN
PD1-OSC_OUT.Signal=RCC_OSC_OUT
