HuynhMinhThuan1310/UAV-FLIGHT-CONTROLLER/mach-UAV-main/firmware/PWM_ADC_TIMER/Core/Src/main.c

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
/* Includes ------------------------------------------------------------------*/
#include "main.h"


/* USER CODE BEGIN Includes */
#include <stdint.h>
/* USER CODE END Includes */

 ADC_HandleTypeDef hadc1;

TIM_HandleTypeDef htim2;
TIM_HandleTypeDef htim3;

/* USER CODE BEGIN PV */
uint32_t adc_buf[4];

uint16_t motor[4] = {1000, 1000, 1000, 1000};

volatile uint8_t control_flag = 0;

#define ADC_BATTERY   adc_buf[0]   // PA4 - IN4
#define ADC_ROLL      adc_buf[1]   // PA5 - IN5
#define ADC_PITCH     adc_buf[2]   // PA6 - IN6
#define ADC_THROTTLE  adc_buf[3]   // PA7 - IN7
/* USER CODE END PV */

void SystemClock_Config(void);
static void MX_GPIO_Init(void);
static void MX_ADC1_Init(void);
static void MX_TIM2_Init(void);
static void MX_TIM3_Init(void);
/**
  * @brief  The application entry point.
  * @retval int
  */
int main(void)
{
  /* MCU Configuration--------------------------------------------------------*/

  /* Reset of all peripherals, Initializes the Flash interface and the Systick. */
  HAL_Init();

  /* Configure the system clock */
  SystemClock_Config();

  /* Initialize all configured peripherals */
  MX_GPIO_Init();
  MX_ADC1_Init();
  MX_TIM2_Init();
  MX_TIM3_Init();
  /* USER CODE BEGIN 2 */
  // Khởi động ADC + DMA
  HAL_ADC_Start_DMA(&hadc1, adc_buf, 4);

  // Khởi động PWM — đúng chân mới PA15, PB3, PB10, PB11
  HAL_TIM_PWM_Start(&htim2, TIM_CHANNEL_1);  // PA15 - Motor 1
  HAL_TIM_PWM_Start(&htim2, TIM_CHANNEL_2);  // PB3  - Motor 2
  HAL_TIM_PWM_Start(&htim2, TIM_CHANNEL_3);  // PB10 - Motor 3
  HAL_TIM_PWM_Start(&htim2, TIM_CHANNEL_4);  // PB11 - Motor 4

  // Khởi động TIM3 interrupt
  HAL_TIM_Base_Start_IT(&htim3);

  // Tất cả motor về idle
  motor[0] = motor[1] = motor[2] = motor[3] = 1000;
  /* USER CODE END 2 */

  /* Infinite loop */
  /* USER CODE BEGIN WHILE */
  while (1)
  {
	  if (control_flag) {
	          control_flag = 0;
	          Control_Loop();
    /* USER CODE END WHILE */

    /* USER CODE BEGIN 3 */
  }
  /* USER CODE END 3 */
}

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
/* USER CODE BEGIN 4 */
void Motor_SetPulse(uint8_t ch, uint16_t val)
{
    if (val < 1000) val = 1000;
    if (val > 2000) val = 2000;

    switch(ch) {
        case 0: __HAL_TIM_SET_COMPARE(&htim2, TIM_CHANNEL_1, val); break; // PA15
        case 1: __HAL_TIM_SET_COMPARE(&htim2, TIM_CHANNEL_2, val); break; // PB3
        case 2: __HAL_TIM_SET_COMPARE(&htim2, TIM_CHANNEL_3, val); break; // PB10
        case 3: __HAL_TIM_SET_COMPARE(&htim2, TIM_CHANNEL_4, val); break; // PB11
    }
}

uint16_t ADC_Map(uint32_t adc_val, uint16_t out_min, uint16_t out_max)
{
    return (uint16_t)(out_min + ((uint32_t)(adc_val) * (out_max - out_min)) / 4095);
}

void Control_Loop(void)
{
    uint16_t throttle = ADC_Map(ADC_THROTTLE, 1000, 2000);
    int16_t roll      = (int16_t)ADC_Map(ADC_ROLL,  0, 400) - 200;
    int16_t pitch     = (int16_t)ADC_Map(ADC_PITCH, 0, 400) - 200;

    // X-frame quadcopter
    motor[0] = throttle + roll - pitch;  // Motor 1 PA15
    motor[1] = throttle - roll - pitch;  // Motor 2 PB3
    motor[2] = throttle + roll + pitch;  // Motor 3 PB10
    motor[3] = throttle - roll + pitch;  // Motor 4 PB11

    for (uint8_t i = 0; i < 4; i++) {
        Motor_SetPulse(i, motor[i]);
    }

    // Nhấp nháy LED PC13 (active low)
    HAL_GPIO_TogglePin(GPIOC, GPIO_PIN_13);
}

void HAL_TIM_PeriodElapsedCallback(TIM_HandleTypeDef *htim)
{
    if (htim->Instance == TIM3) {
        control_flag = 1;
    }
}
/* USER CODE END 4 */
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
