HuynhMinhThuan1310/UAV-FLIGHT-CONTROLLER/(commit log)

2026-10-14 feat: complete UAV Flight Controller PCB design and ESP32-C3 Telemetry Ground Station
2026-10-14 feat(stm32): add STM32CubeIDE firmware projects for UAV Flight Controller
2026-10-14 docs: update comprehensive README for STM32 FC, KiCad PCB, and ESP32 GCS
2026-10-14 refactor: rename PCB design directory to thiet_ke_mach
