HuynhMinhThuan1310/UAV-FLIGHT-CONTROLLER/(notices)

Notices in the files:
mach-UAV-main/firmware/PWM_ADC_TIMER/Core/Src/main.c:
Copyright (c) 2026 STMicroelectronics.
All rights reserved.
This software is licensed under terms that can be found in the LICENSE file
